DallinLowEngineering/QC_CNC_Machine/QC CNC V2, BOM (No links; SW Gen.).xlsx

ITEM NO. | PART NUMBER | QTY.
1 | 400mm (T-Slot, 2040) | 2
2 | 400mm (T-Slot, 2020) | 3
3 | B18.6.7M - M4 x 0.7 x 16 Type I Cross Recessed PHMS --16N | 12
4 | T-Nut, m4 | 39
5 | B18.2.4.1M - Hex nut, Style 1, M4 x 0.7 --D-N | 15
6 | Reverse Adapter, Pillow Block, M4 to M4 | 3
7 | Pillow Block, 8mm clearance, Fasteners M4 | 3
8 | Lead Screw Coupler, 5-8mm | 3
9 | 300mm (Lead Screw, T8) | 3
10 | 3D Printed, Motor Bracket, RH, Nema 17 | 3
11 | Stepper Motor, Nema 17 | 3
12 | B18.6.7M - M3 x 0.5 x 5 Type I Cross Recessed PHMS --5N | 12
13 | B18.6.7M - M4 x 0.7 x 8 Type I Cross Recessed PHMS --8N | 16
14 | Corner Bracket, 2020, 6mm holes | 6
15 | T-Slot, 2020 | 1
16 | Mounting Plate, Electronics | 1
17 | B18.6.7M - M4 x 0.7 x 13 Type I Cross Recessed PHMS --13N | 9
18 | B18.22M - Plain washer, 4 mm, regular | 18
19 | Board, Ramps 1.4 | 1
20 | DIN Rail (8961K150) | 2
21 | 3D Printed, DIN Mounts, Arduino Mega | 2
22 | Board, Arduino Mega | 1
23 | B18.6.7M - M3 x 0.5 x 13 Type I Cross Recessed PHMS --13N | 4
24 | B18.2.4.1M - Hex nut, Style 1, M3 x 0.5 --D-N | 20
25 | 12V Power Supply | 1
26 | 3D Printed, Wheel Carriage, Front, 2020, V2 | 2
27 | Wheel, Preloaded, 5mm bore | 9
28 | T8 (Lead Screw Nut) | 3
29 | 3D Printed, Wheel Carriage, Rear, 2020, Y, V2 | 2
30 | Spacer, M4, 10mm | 18
31 | m4x50mm, PHIL, Pan Head | 9
32 | B18.21.2M-Internal Tooth Lock Washers_AM4 | 9
33 | B18.6.7M - M3 x 0.5 x 16 Type I Cross Recessed PHMS --16N | 16
34 | 3D Printed, Wheel Carriage, Front, 2020, Reflected, V2 | 1
35 | 3D Printed, Wheel Carriage, Rear, 2020, V2 | 1
36 | Laser Diode | 1
37 | ToF laser Board | 1
38 | 3D Printed, Laser Bracket, Actual | 1
39 | 3D Printed, Bracket, End Stop | 2
40 | Board, End Stop | 2
41 | B18.6.7M - M3 x 0.5 x 8 Type I Cross Recessed PHMS --8NPCS | 4
42 | B18.6.7M - M4 x 0.7 x 8 Type I Cross Recessed PHMS --8NPCS | 4
43 | B18.6.7M - M4 x 0.7 x 10 Type I Cross Recessed PHMS --10NPCS | 4
