DallinLowEngineering/QC_CNC_Machine/RH, Y-Carriage, V2.SLDASM

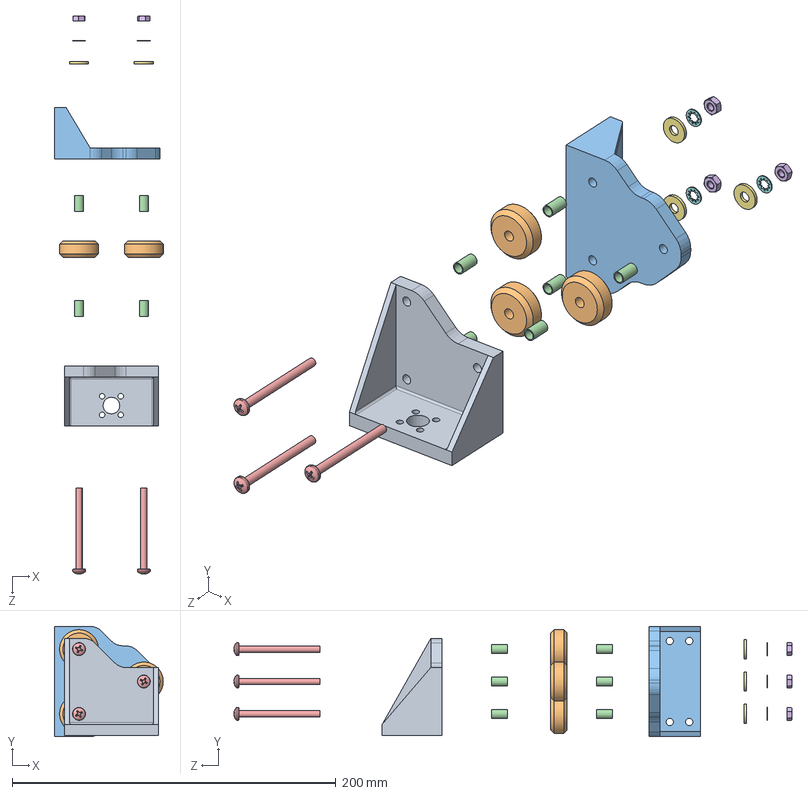
[picture p1: CAD file, 2021-05-12]
RH, Y-Carriage, V2.SLDASM
67.0 x 68.0 x 344.5 mm
3D Printed, Wheel Carriage, Front, 2020, Reflected, V2
Wheel, Preloaded, 5mm bore x 3
3D Printed, Wheel Carriage, Rear, 2020, Y, V2
Spacer, M4, 10mm x 6
m4x50mm, PHIL, Pan Head x 3
hex nut style 1_am x 3
flat washer regular_am x 3
internal tooth lock washer_am x 3
