DallinLowEngineering/QC_CNC_Machine/LH, Y-Carriage, V2.SLDASM

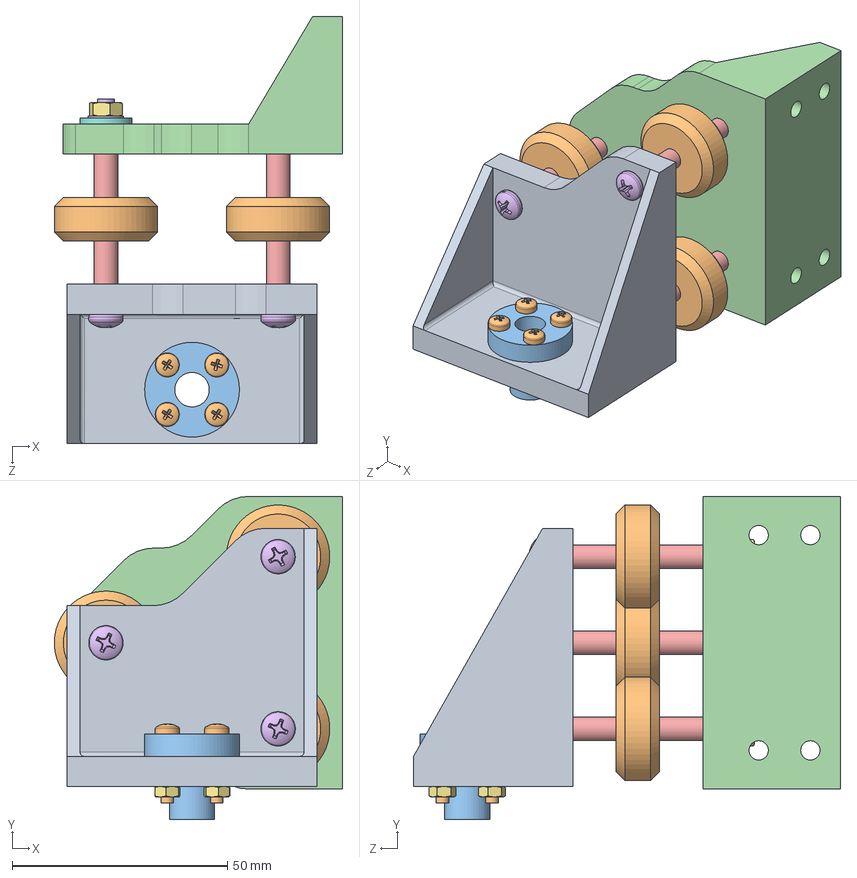
[picture p2: CAD file, 2021-05-12]
LH, Y-Carriage, V2.SLDASM
67.0 x 75.1 x 99.2 mm
3D Printed, Wheel Carriage, Front, 2020, V2
Wheel, Preloaded, 5mm bore x 3
Lead Screw Nut, M8 (Standin; 2391N110)
3D Printed, Wheel Carriage, Rear, 2020, Y, V2
Spacer, M4, 10mm x 6
m4x50mm, PHIL, Pan Head x 3
hex nut style 1_am x 7
flat washer regular_am x 3
internal tooth lock washer_am x 3
pan cross head_am x 4
