DallinLowEngineering/QC_CNC_Machine/X-Carriage, QC Range Finder.SLDASM

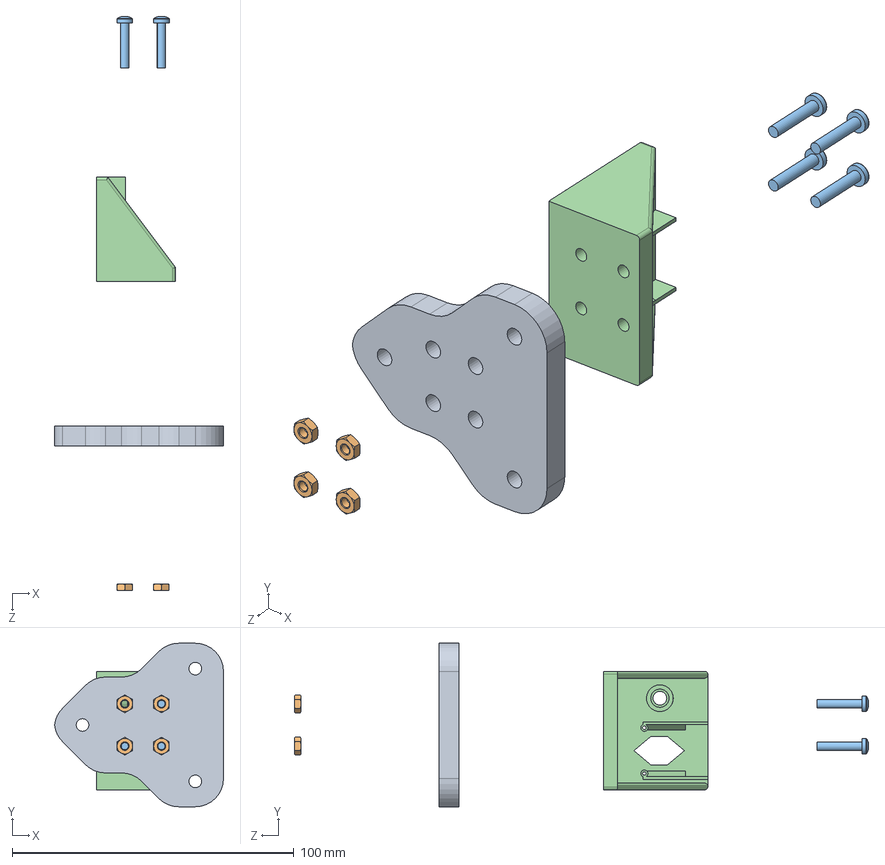
[picture p3: CAD file, 2021-05-12]
X-Carriage, QC Range Finder.SLDASM
59.9 x 58.0 x 203.7 mm
3D Printed, Wheel Carriage, Rear, 2020, V2
hex nut style 1_am x 4
pan cross head_am x 4
3D Printed, Laser Bracket, Actual
