DallinLowEngineering/QC_CNC_Machine/3D Printed, Bracket, End Stop.STEP

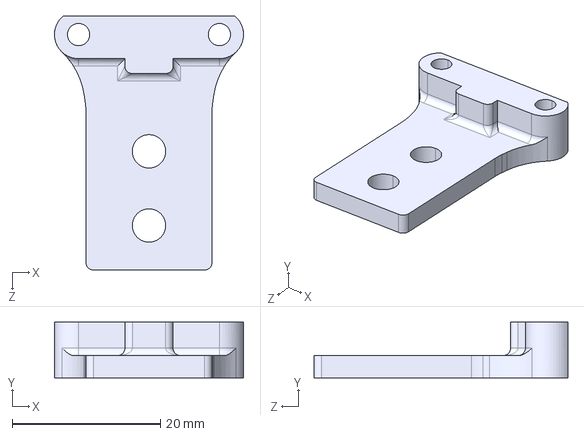
[picture p4: CAD file, 2021-05-12]
3D Printed, Bracket, End Stop.STEP
25.5 x 7.50 x 34.3 mm
