DallinLowEngineering/QC_CNC_Machine/3D Printed, Wheel Carriage, Front, 2020, V2.STEP

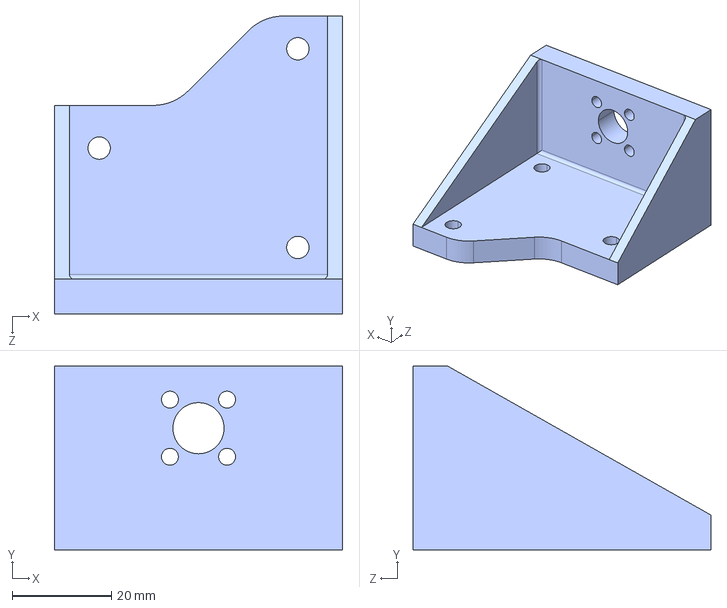
[picture p5: CAD file, 2021-05-12]
3D Printed, Wheel Carriage, Front, 2020, V2.STEP
58.0 x 37.0 x 60.0 mm
