DallinLowEngineering/QC_CNC_Machine/T-Nut, m4.SLDPRT

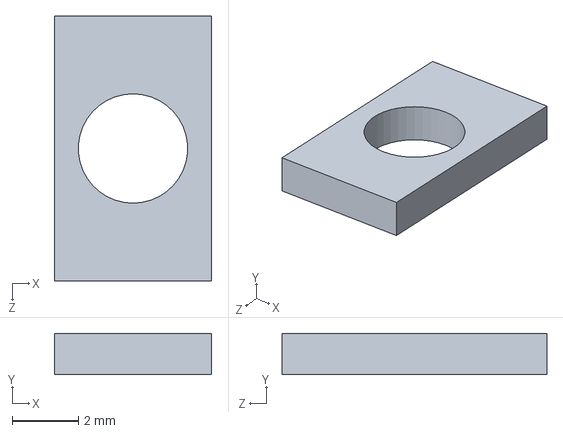
[picture p6: CAD file, 2021-05-12]
T-Nut, m4.SLDPRT
4.75 x 1.25 x 8.00 mm
