DallinLowEngineering/QC_CNC_Machine/Spacer, M4, 10mm.SLDPRT

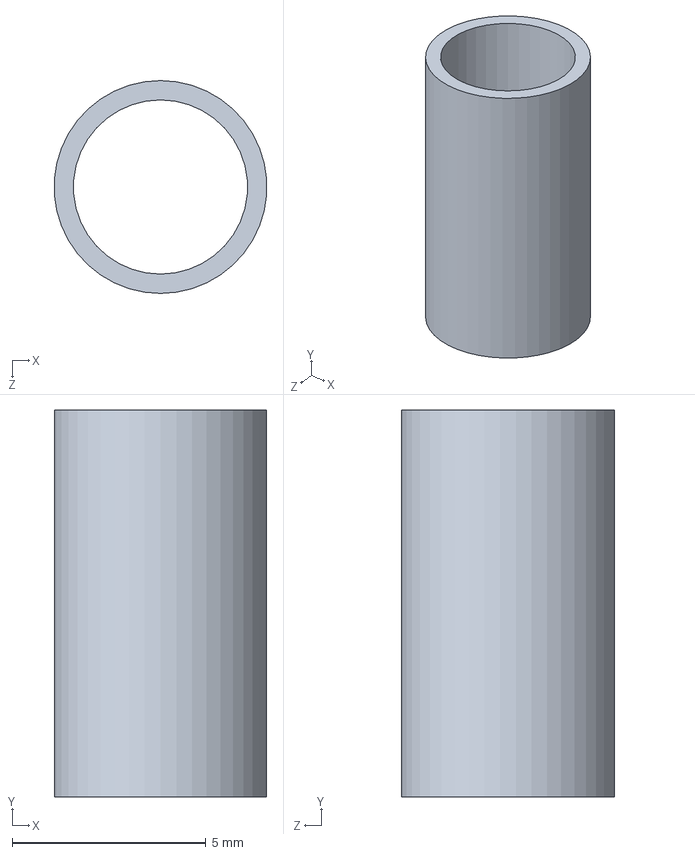
[picture p7: CAD file, 2021-05-12]
Spacer, M4, 10mm.SLDPRT
5.48 x 10.0 x 5.50 mm
