DallinLowEngineering/QC_CNC_Machine/DIN Rail (8961K150).SLDPRT

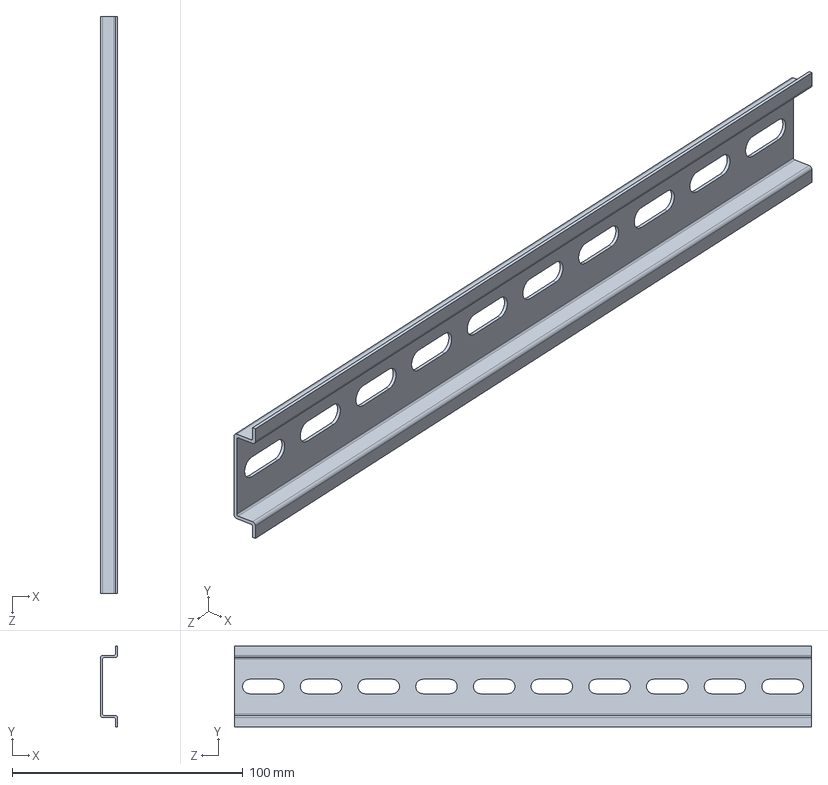
[picture p8: CAD file, 2021-05-12]
DIN Rail (8961K150).SLDPRT
7.50 x 35.0 x 250.0 mm
