DallinLowEngineering/QC_CNC_Machine/T-Slot, 2040.SLDPRT

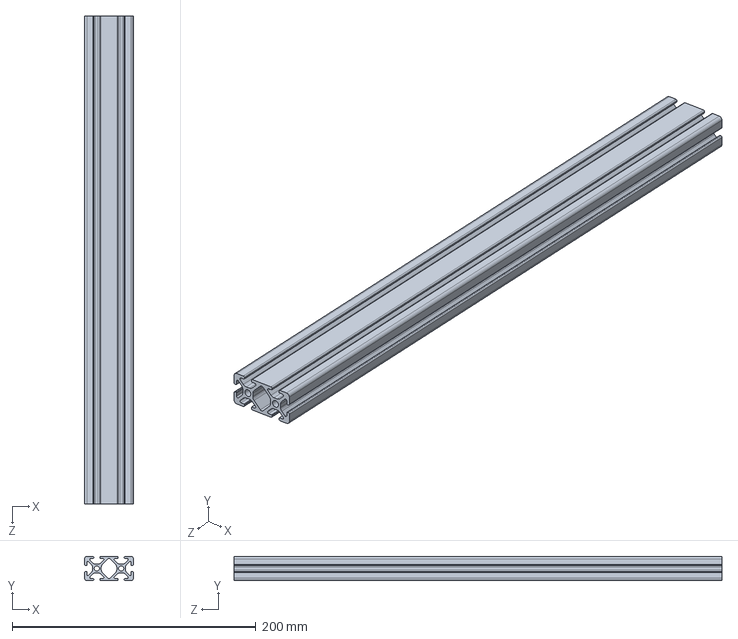
[picture p9: CAD file, 2021-05-12]
T-Slot, 2040.SLDPRT
40.0 x 20.0 x 400.0 mm
