DallinLowEngineering/QC_CNC_Machine/12V Power Supply.SLDPRT

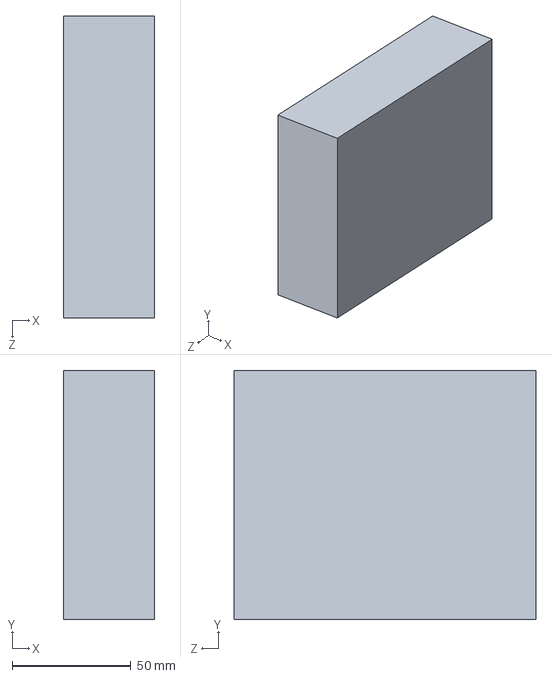
[picture p10: CAD file, 2021-05-12]
12V Power Supply.SLDPRT
38.1 x 104.8 x 127.0 mm
