DallinLowEngineering/QC_CNC_Machine/3D Printed, Motor Bracket, RH, Nema 17.STEP

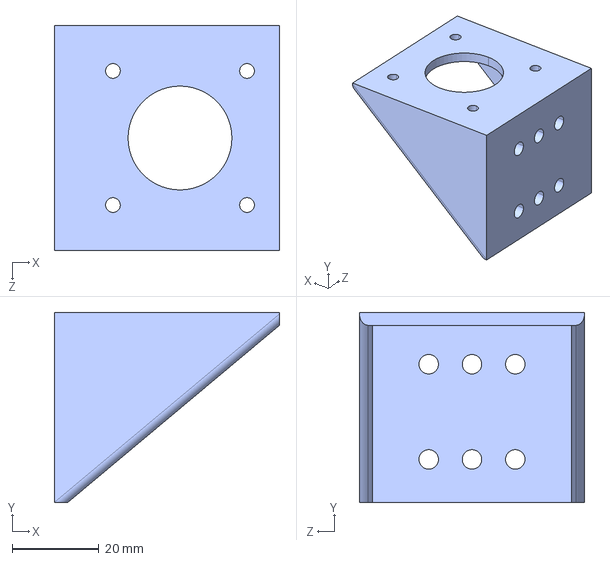
[picture p11: CAD file, 2021-05-12]
3D Printed, Motor Bracket, RH, Nema 17.STEP
52.0 x 44.0 x 52.0 mm
