DallinLowEngineering/QC_CNC_Machine/Pillow Block, 8mm clearance, Fasteners M4.SLDPRT

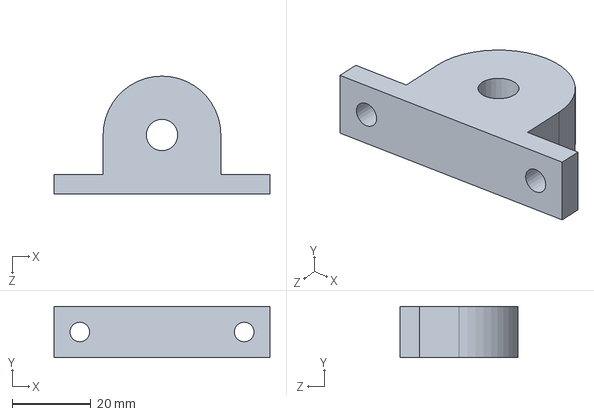
[picture p12: CAD file, 2021-05-12]
Pillow Block, 8mm clearance, Fasteners M4.SLDPRT
55.0 x 13.0 x 30.0 mm
