DallinLowEngineering/QC_CNC_Machine/ToF laser Board.SLDPRT

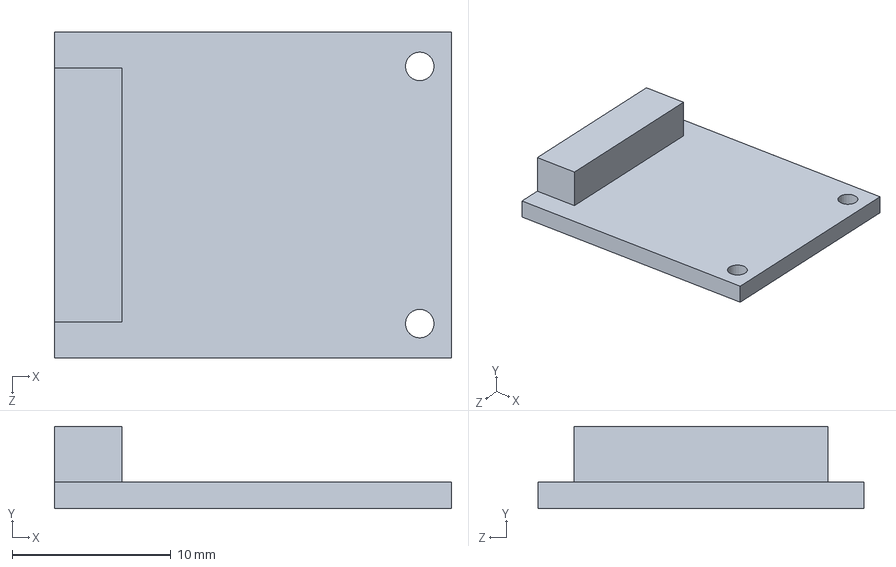
[picture p13: CAD file, 2021-05-12]
ToF laser Board.SLDPRT
25.0 x 5.17 x 20.5 mm
