DallinLowEngineering/QC_CNC_Machine/Board, End Stop.SLDPRT

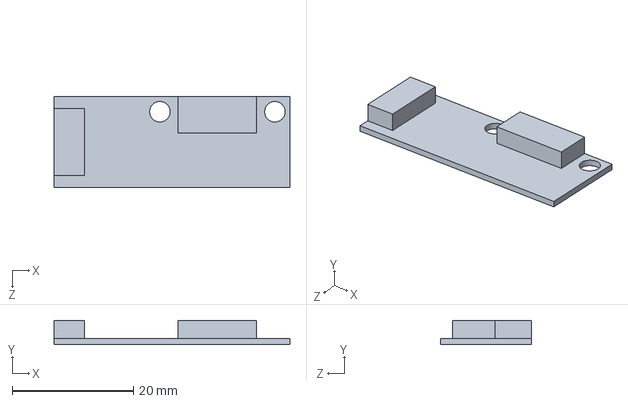
[picture p14: CAD file, 2021-05-12]
Board, End Stop.SLDPRT
39.0 x 4.00 x 15.0 mm
