DallinLowEngineering/QC_CNC_Machine/Board, Arduino Mega.SLDPRT

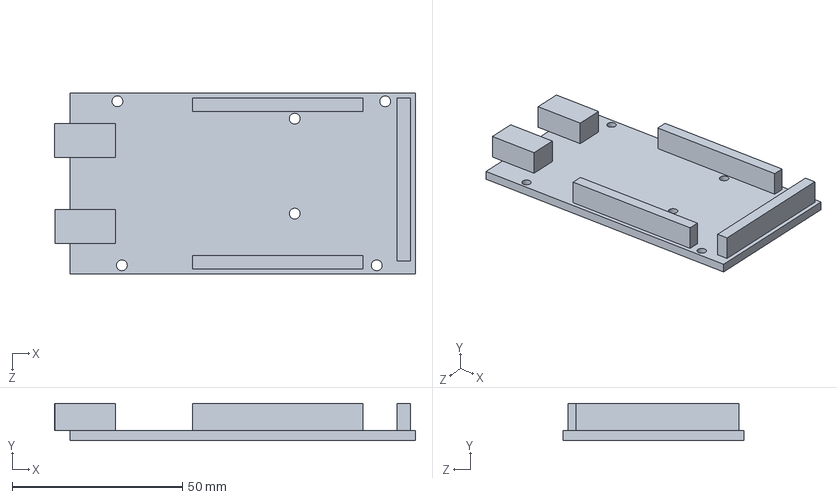
[picture p15: CAD file, 2021-05-12]
Board, Arduino Mega.SLDPRT
106.1 x 11.0 x 53.3 mm
