DallinLowEngineering/QC_CNC_Machine/Mounting Plate, Electronics.SLDPRT

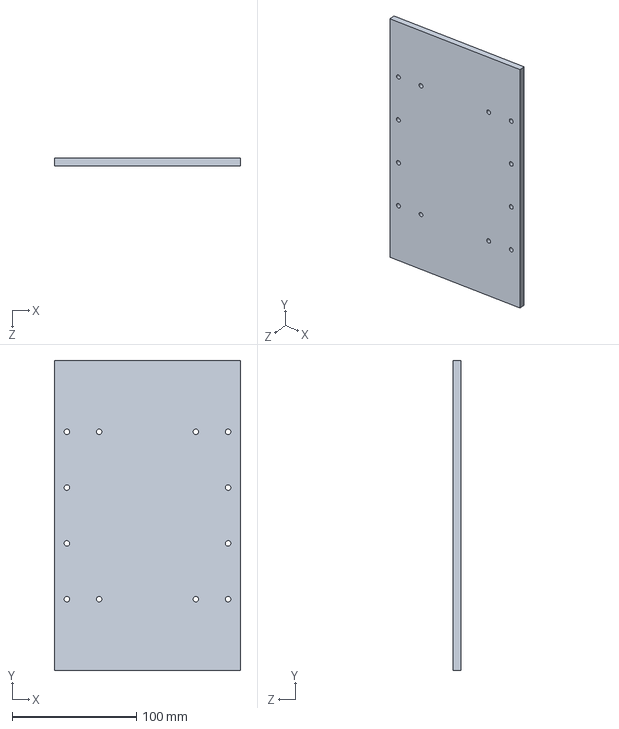
[picture p16: CAD file, 2021-05-12]
Mounting Plate, Electronics.SLDPRT
150.0 x 250.0 x 6.35 mm
