DallinLowEngineering/QC_CNC_Machine/3D Printed, Wheel Carriage, Rear, 2020, V2.STEP

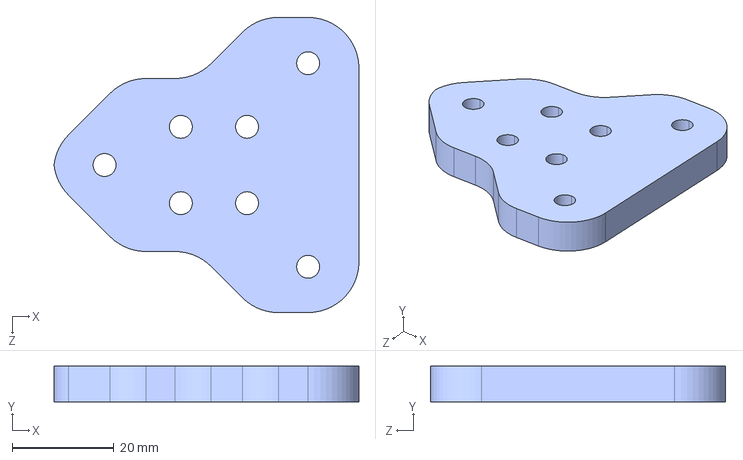
[picture p17: CAD file, 2021-05-12]
3D Printed, Wheel Carriage, Rear, 2020, V2.STEP
59.9 x 7.00 x 58.0 mm
