DallinLowEngineering/QC_CNC_Machine/Laser Diode.SLDPRT

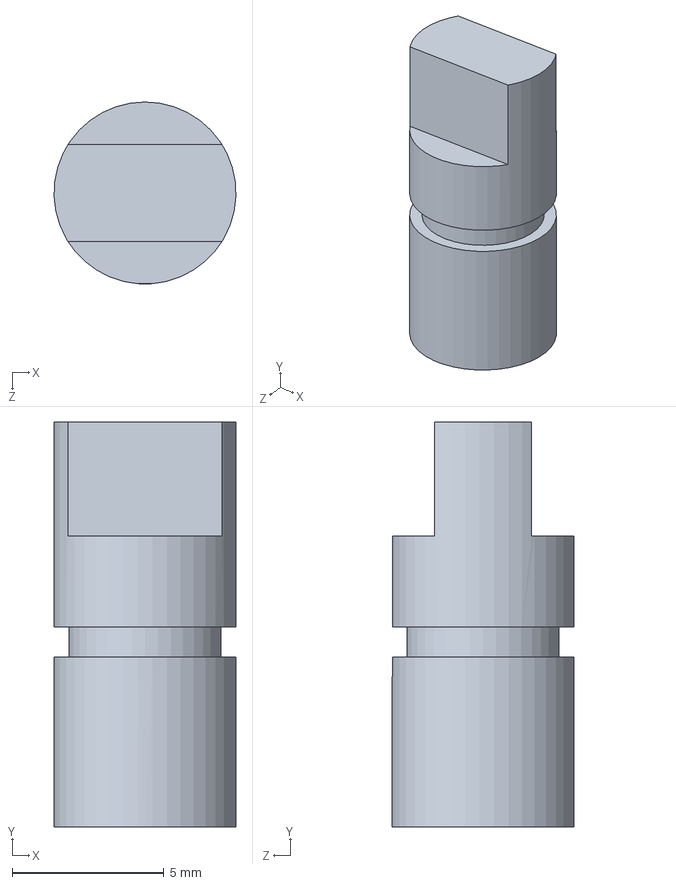
[picture p18: CAD file, 2021-05-12]
Laser Diode.SLDPRT
6.00 x 13.3 x 6.00 mm
