DallinLowEngineering/QC_CNC_Machine/3D Printed, Laser Bracket, Actual.STEP

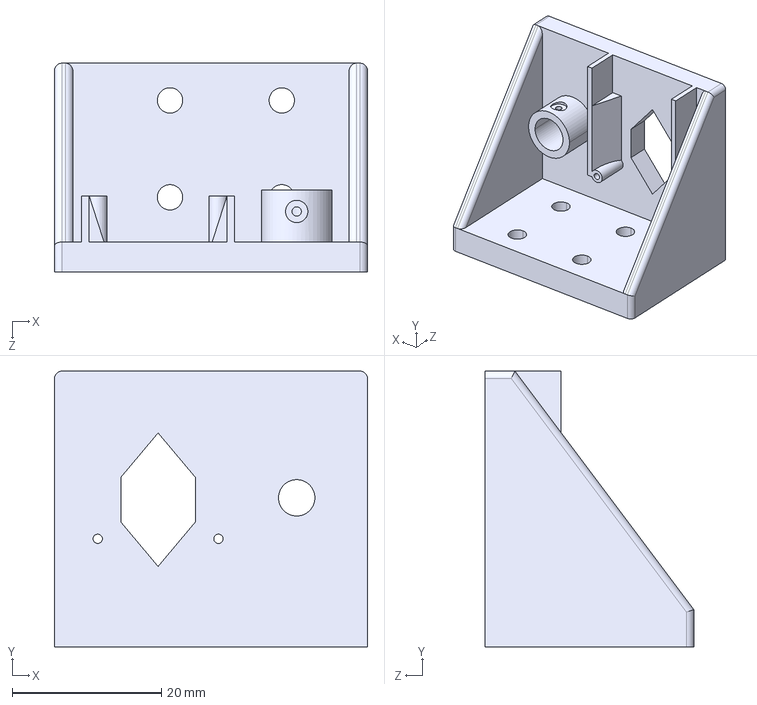
[picture p19: CAD file, 2021-05-12]
3D Printed, Laser Bracket, Actual.STEP
42.0 x 37.0 x 28.0 mm
