DallinLowEngineering/QC_CNC_Machine/Board, Ramps 1.4.SLDPRT

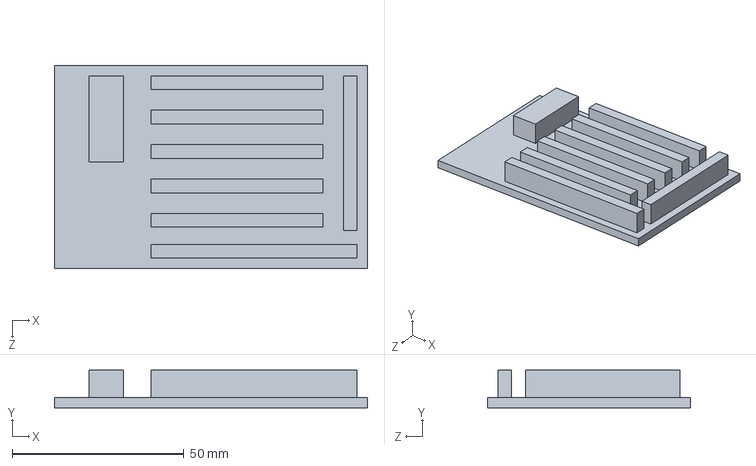
[picture p20: CAD file, 2021-05-12]
Board, Ramps 1.4.SLDPRT
91.0 x 11.0 x 59.0 mm
