DallinLowEngineering/QC_CNC_Machine/Reverse Adapter, Pillow Block, M4 to M4.STEP

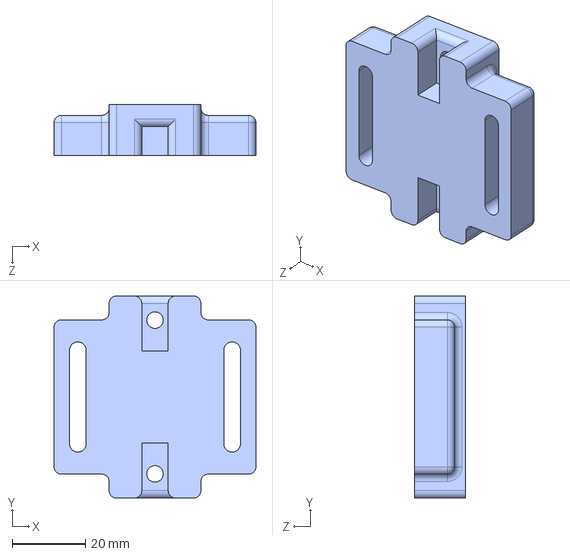
[picture p21: CAD file, 2021-05-12]
Reverse Adapter, Pillow Block, M4 to M4.STEP
55.0 x 55.0 x 14.0 mm
