DallinLowEngineering/QC_CNC_Machine/Corner Bracket, 2020, 6mm holes.SLDPRT

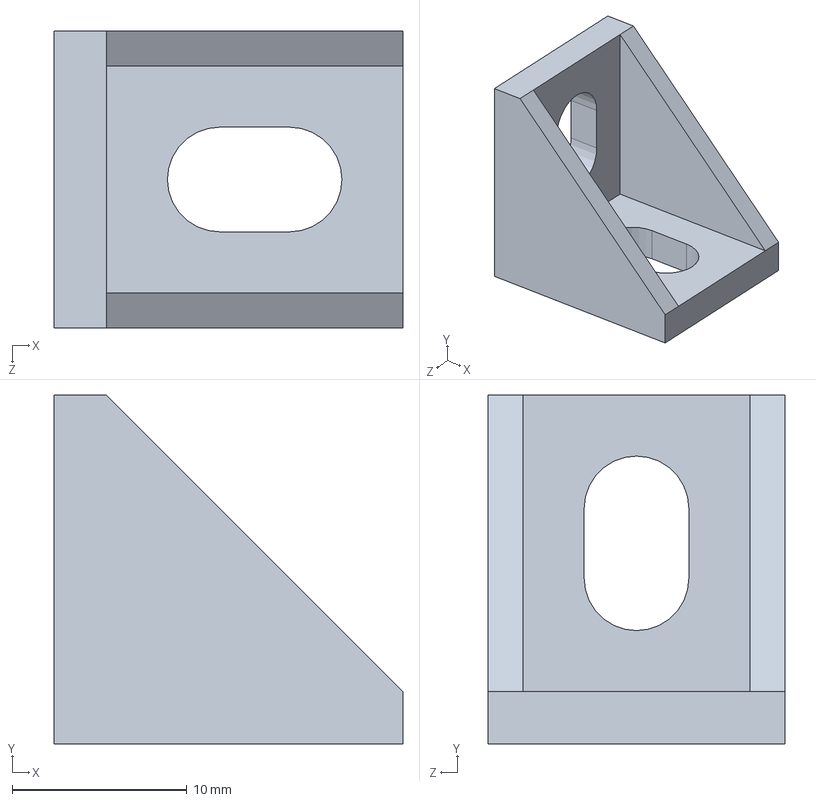
[picture p22: CAD file, 2021-05-12]
Corner Bracket, 2020, 6mm holes.SLDPRT
20.0 x 20.0 x 17.0 mm
