DallinLowEngineering/QC_CNC_Machine/3D Printed, Wheel Carriage, Rear, 2020, Y, V2.STEP

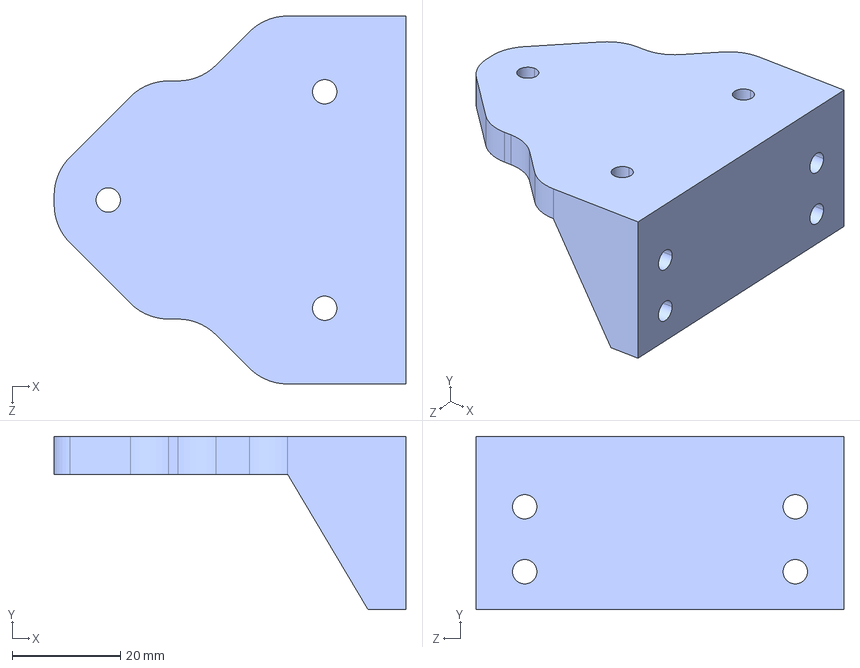
[picture p23: CAD file, 2021-05-12]
3D Printed, Wheel Carriage, Rear, 2020, Y, V2.STEP
65.0 x 32.0 x 68.0 mm
