DallinLowEngineering/QC_CNC_Machine/Wheel, Preloaded, 5mm bore.SLDPRT

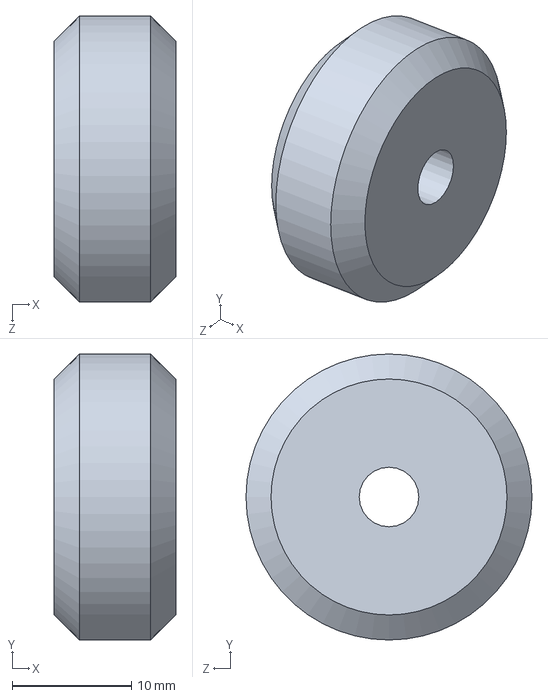
[picture p24: CAD file, 2021-05-12]
Wheel, Preloaded, 5mm bore.SLDPRT
10.2 x 24.0 x 24.0 mm
