DallinLowEngineering/QC_CNC_Machine/Stepper Motor, Nema 17 (6627T660).SLDPRT

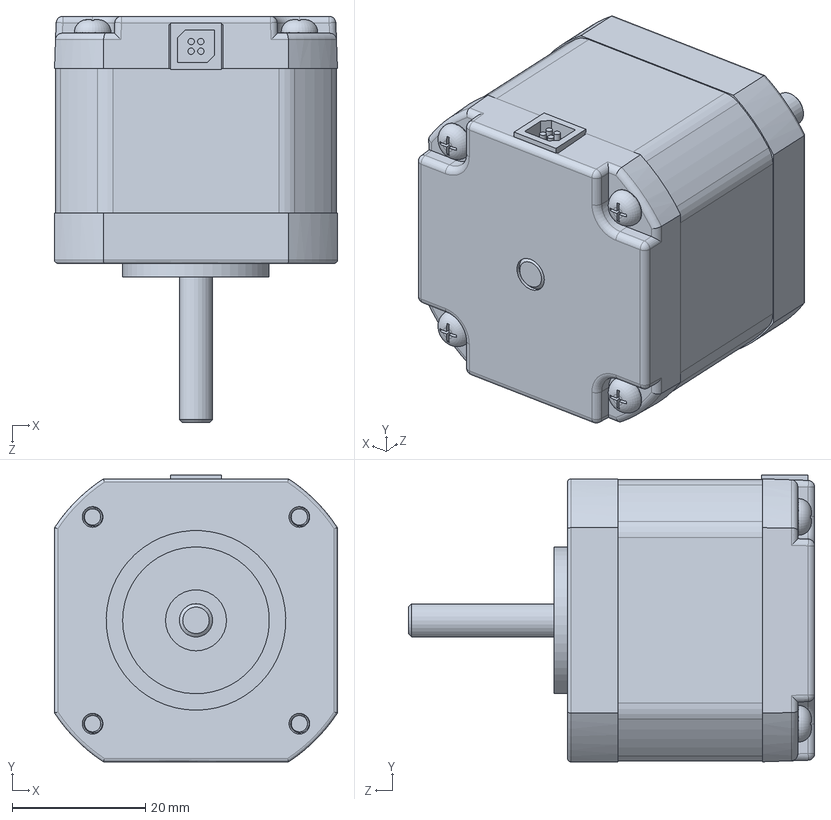
[picture p25: CAD file, 2021-05-12]
Stepper Motor, Nema 17 (6627T660).SLDPRT
42.4 x 43.0 x 60.9 mm
