DallinLowEngineering/QC_CNC_Machine/3D Printed, DIN Mounts, Arduino Mega.STEP

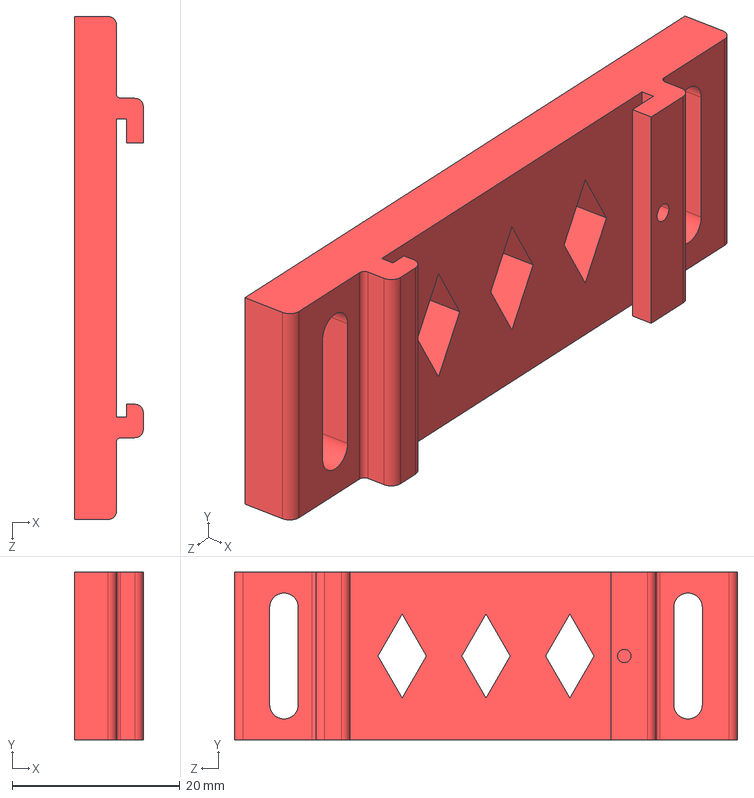
[picture p26: CAD file, 2021-05-12]
3D Printed, DIN Mounts, Arduino Mega.STEP
8.20 x 20.0 x 60.0 mm
