DallinLowEngineering/QC_CNC_Machine/T-Slot, 2020.SLDPRT

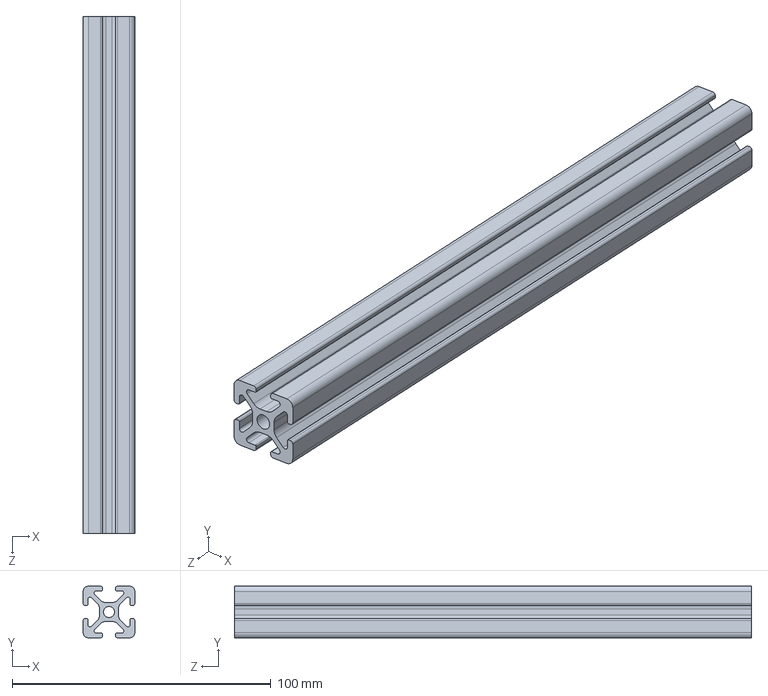
[picture p27: CAD file, 2021-05-12]
T-Slot, 2020.SLDPRT
20.0 x 20.0 x 200.0 mm
