DallinLowEngineering/QC_CNC_Machine/(list of files, cad)

Other CAD files:
3D Printed, Wheel Carriage, Front, 2020, Reflected, V2.STEP
3D Printed, Bracket, End Stop.SLDPRT
3D Printed, Bracket, End Stop.STL
3D Printed, DIN Mounts, Arduino Mega.SLDPRT
3D Printed, DIN Mounts, Arduino Mega.STL
3D Printed, Laser Bracket, Actual.SLDPRT
3D Printed, Laser Bracket, Actual.STL
3D Printed, Motor Bracket, RH, Nema 17.SLDPRT
3D Printed, Motor Bracket, RH, Nema 17.STL
3D Printed, Wheel Carriage, Front, 2020, Reflected, V2.SLDPRT
3D Printed, Wheel Carriage, Front, 2020, Reflected, V2.STL
3D Printed, Wheel Carriage, Front, 2020, V2.SLDPRT
3D Printed, Wheel Carriage, Front, 2020, V2.STL
3D Printed, Wheel Carriage, Rear, 2020, V2.SLDPRT
3D Printed, Wheel Carriage, Rear, 2020, V2.STL
3D Printed, Wheel Carriage, Rear, 2020, Y, V2.SLDPRT
3D Printed, Wheel Carriage, Rear, 2020, Y, V2.STL
Lead Screw Coupler, 5-8mm.SLDPRT
Lead Screw Nut, M8 (Standin; 2391N110).SLDPRT
Lead Screw, M8 (T8 Stand-in), 300mm (7549K570).SLDPRT
Mounting Plate, Electronics.SLDDRW
QC CNC Machine V2, Assembly (PRJ3).SLDDRW
Reverse Adapter, Pillow Block, M4 to M4.SLDPRT
Reverse Adapter, Pillow Block, M4 to M4.STL
m4x50mm, PHIL, Pan Head.SLDPRT
