DallinLowEngineering/QC_CNC_Machine/QC CNC Machine V2, Assembly Drawing (PRJ3).PDF

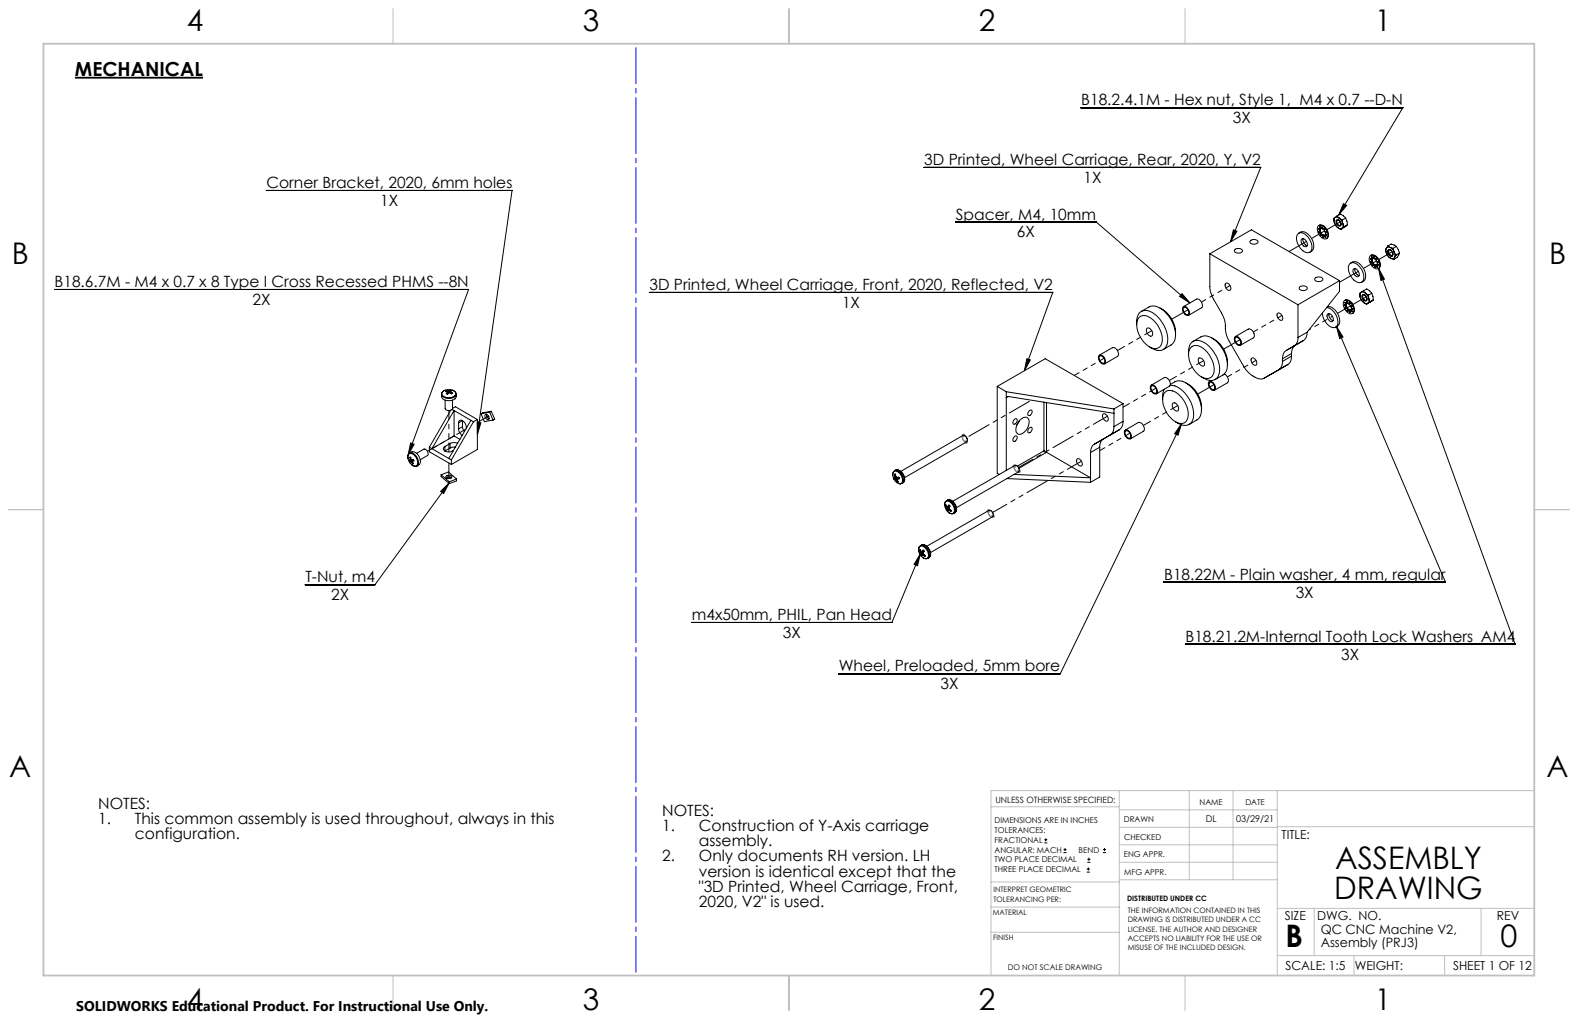
[picture p28: page 1]
T-Nut, m4; Spacer, M4, 10mm; SHEET 1 OF 12; SCALE: 1:5; WEIGHT:

B18.2.4.1M - Hex nut, Style 1, M4 x 0.7 --D-N

3D Printed, Wheel Carriage, Rear, 2020, Y, V2

Corner Bracket, 2020, 6mm holes

B18.6.7M - M4 x 0.7 x 8 Type I Cross Recessed PHMS --8N

3D Printed, Wheel Carriage, Front, 2020, Reflected, V2

B18.22M - Plain washer, 4 mm, regular

m4x50mm, PHIL, Pan Head

Wheel, Preloaded, 5mm bore

B18.21.2M-Internal Tooth Lock Washers_AM4

NOTES:
1. This common assembly is used throughout, always in this
configuration.

1. Construction of Y-Axis carriage
assembly.
2. Only documents RH version. LH
version is identical except that the
"3D Printed, Wheel Carriage, Front,
2020, V2" is used.

UNLESS OTHERWISE SPECIFIED: | | NAME | DATE
DIMENSIONS ARE IN INCHES TOLERANCES: FRACTIONAL ANGULAR: MACH BEND TWO PLACE DECIMAL THREE PLACE DECIMAL | DRAWN | DL | 03/29/21

CHECKED | | | TITLE: ASSEMBLY DRAWING

ENG APPR.
MFG APPR.

INTERPRET GEOMETRIC TOLERANCING PER: | DISTRIBUTED UNDER CC THE INFORMATION CONTAINED IN THIS DRAWING IS DISTRIBUTED UNDER A CC LICENSE. THE AUTHOR AND DESIGNER ACCEPTS NO LIABILITY FOR THE USE OR MISUSE OF THE INCLUDED DESIGN.
MATERIAL | | SIZE B | DWG. NO. QC CNC Machine V2, Assembly (PRJ3) | REV 0

DO NOT SCALE DRAWING

SOLIDWORKS Educational Product. For Instructional Use Only.

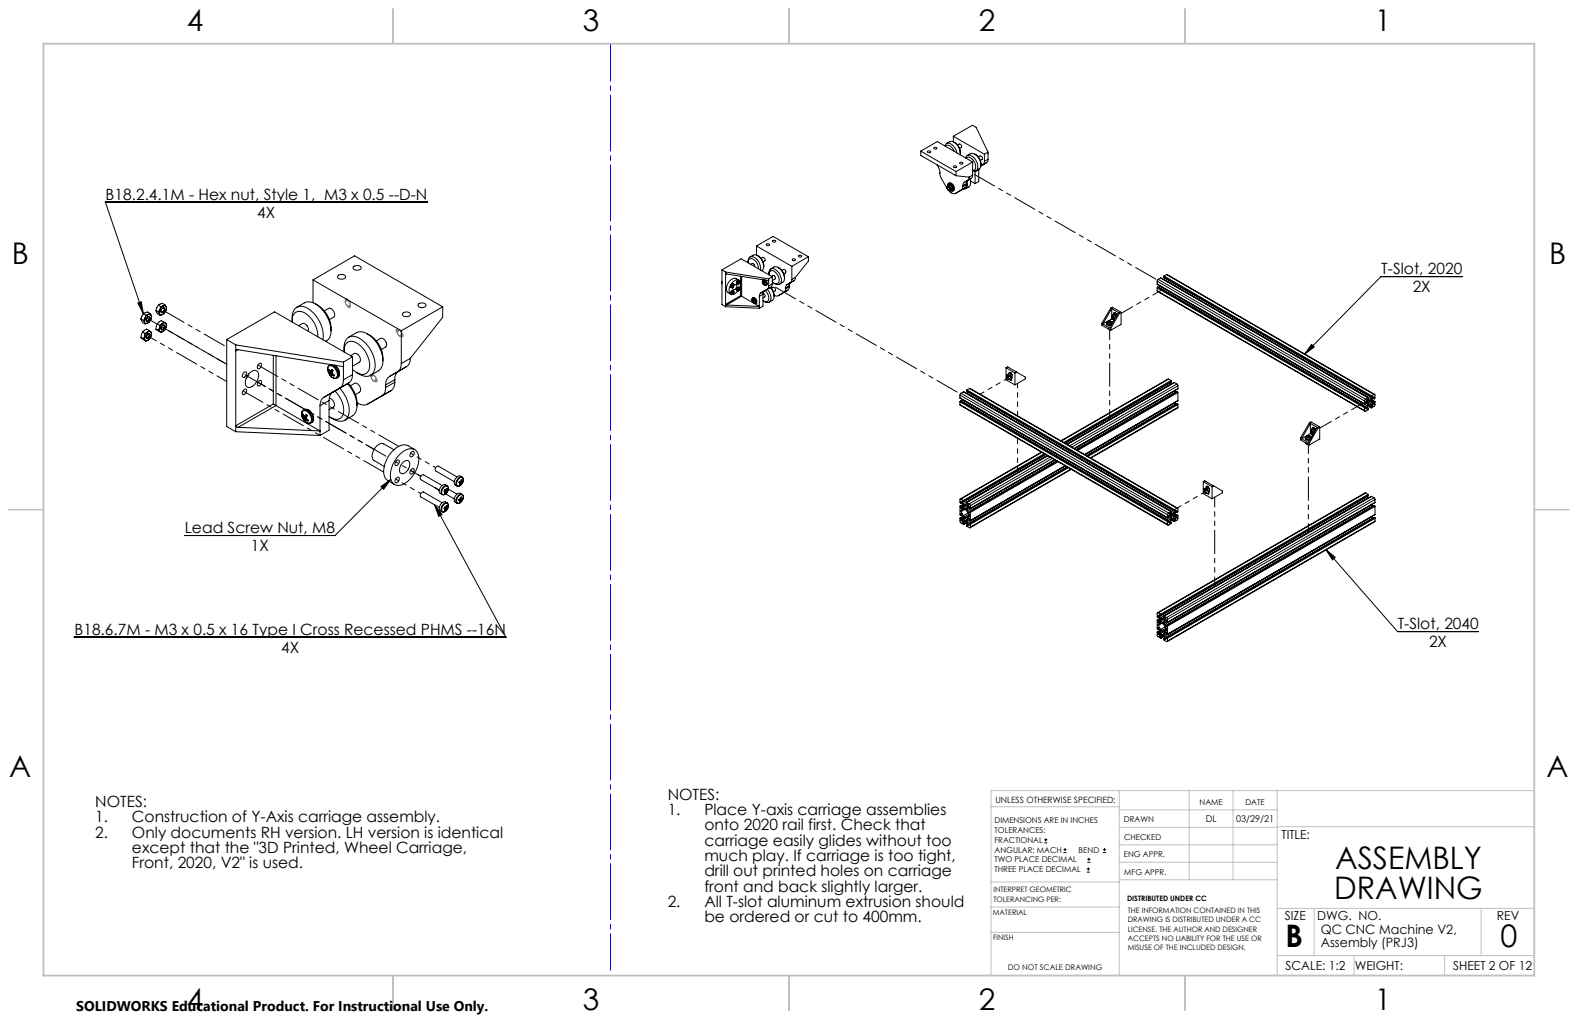
[picture p29: page 2]
T-Slot, 2020; T-Slot, 2040; SCALE: 1:2; WEIGHT:

B18.2.4.1M - Hex nut, Style 1, M3 x 0.5 --D-N

Lead Screw Nut, M8

B18.6.7M - M3 x 0.5 x 16 Type I Cross Recessed PHMS --16N

NOTES:
1. Place Y-axis carriage assemblies
onto 2020 rail first. Check that
carriage easily glides without too
much play. If carriage is too tight,
drill out printed holes on carriage
front and back slightly larger.
2. All T-slot aluminum extrusion should
be ordered or cut to 400mm.

1. Construction of Y-Axis carriage assembly.
2. Only documents RH version. LH version is identical
except that the "3D Printed, Wheel Carriage,
Front, 2020, V2" is used.

UNLESS OTHERWISE SPECIFIED: | | NAME | DATE
DIMENSIONS ARE IN INCHES TOLERANCES: FRACTIONAL ANGULAR: MACH BEND TWO PLACE DECIMAL THREE PLACE DECIMAL | DRAWN | DL | 03/29/21

CHECKED | | | TITLE: ASSEMBLY DRAWING

ENG APPR.
MFG APPR.

INTERPRET GEOMETRIC TOLERANCING PER: | DISTRIBUTED UNDER CC THE INFORMATION CONTAINED IN THIS DRAWING IS DISTRIBUTED UNDER A CC LICENSE. THE AUTHOR AND DESIGNER
MATERIAL | | SIZE B | DWG. NO. QC CNC Machine V2, | REV 0

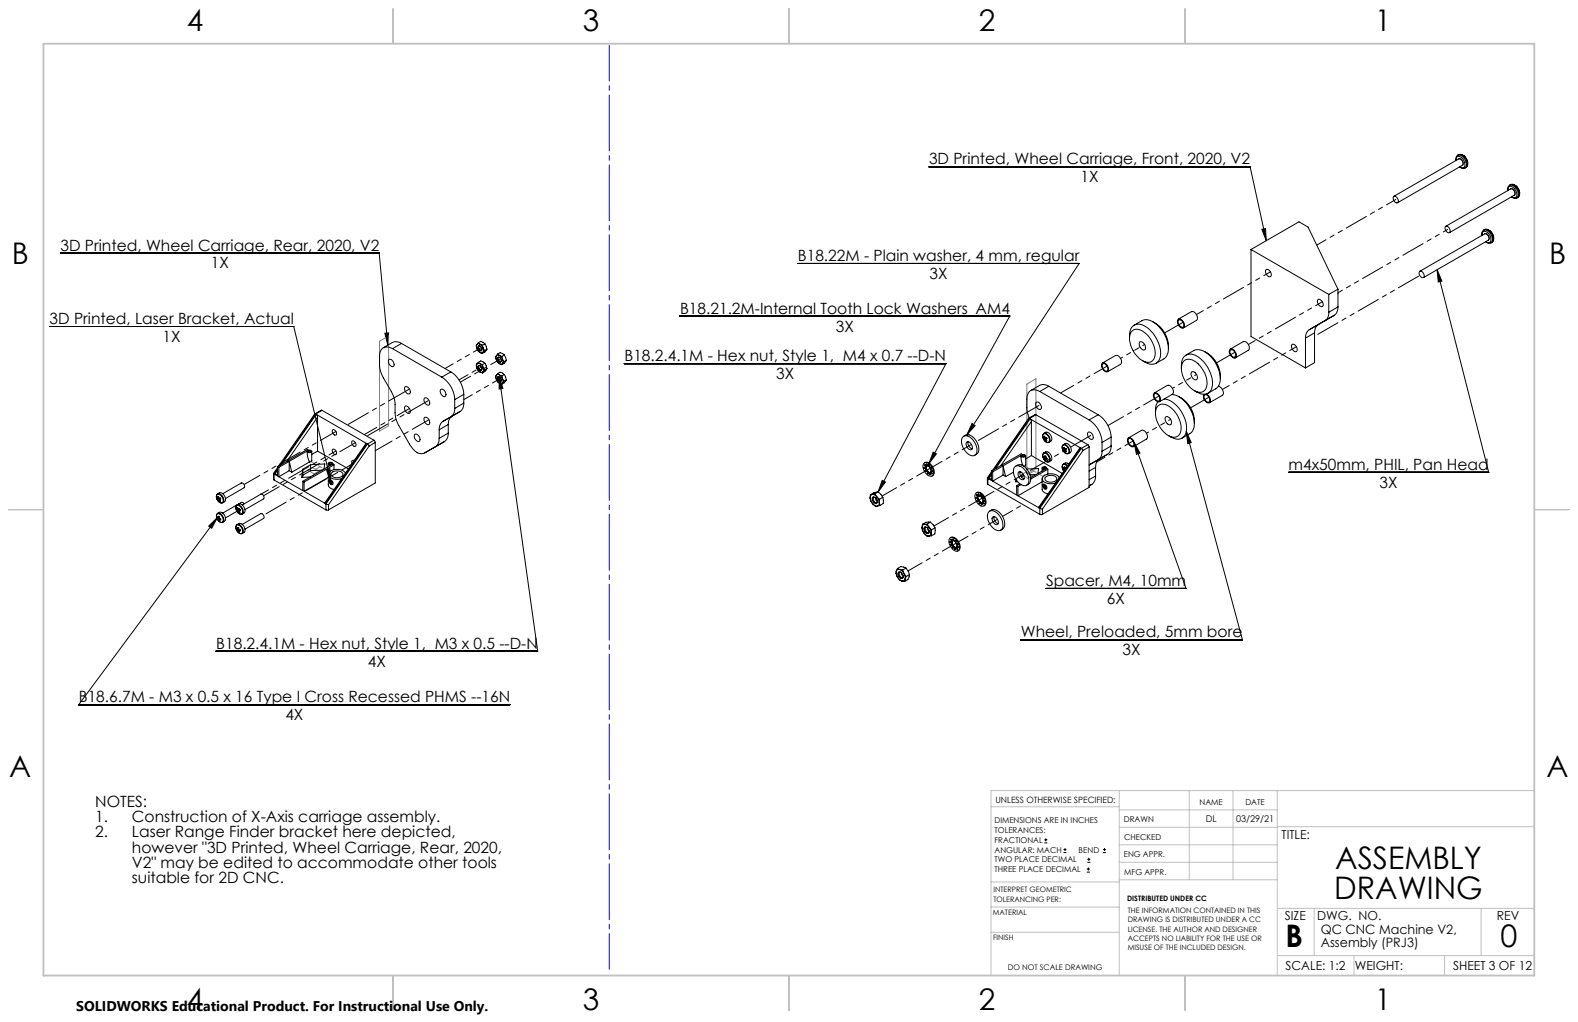
[picture p30: page 3]
Spacer, M4, 10mm

3D Printed, Wheel Carriage, Front, 2020, V2

3D Printed, Wheel Carriage, Rear, 2020, V2

B18.22M - Plain washer, 4 mm, regular

B18.21.2M-Internal Tooth Lock Washers_AM4

3D Printed, Laser Bracket, Actual

B18.2.4.1M - Hex nut, Style 1, M4 x 0.7 --D-N

m4x50mm, PHIL, Pan Head

Wheel, Preloaded, 5mm bore

B18.2.4.1M - Hex nut, Style 1, M3 x 0.5 --D-N

B18.6.7M - M3 x 0.5 x 16 Type I Cross Recessed PHMS --16N

NOTES:
1. Construction of X-Axis carriage assembly.
2. Laser Range Finder bracket here depicted,
however "3D Printed, Wheel Carriage, Rear, 2020,
V2" may be edited to accommodate other tools
suitable for 2D CNC.

UNLESS OTHERWISE SPECIFIED: | | NAME | DATE
DIMENSIONS ARE IN INCHES TOLERANCES: FRACTIONAL ANGULAR: MACH BEND TWO PLACE DECIMAL THREE PLACE DECIMAL | DRAWN | DL | 03/29/21

CHECKED | | | TITLE: ASSEMBLY DRAWING

ENG APPR.
MFG APPR.

INTERPRET GEOMETRIC TOLERANCING PER: | DISTRIBUTED UNDER CC THE INFORMATION CONTAINED IN THIS DRAWING IS DISTRIBUTED UNDER A CC LICENSE. THE AUTHOR AND DESIGNER
MATERIAL | | SIZE B | DWG. NO. QC CNC Machine V2, | REV 0

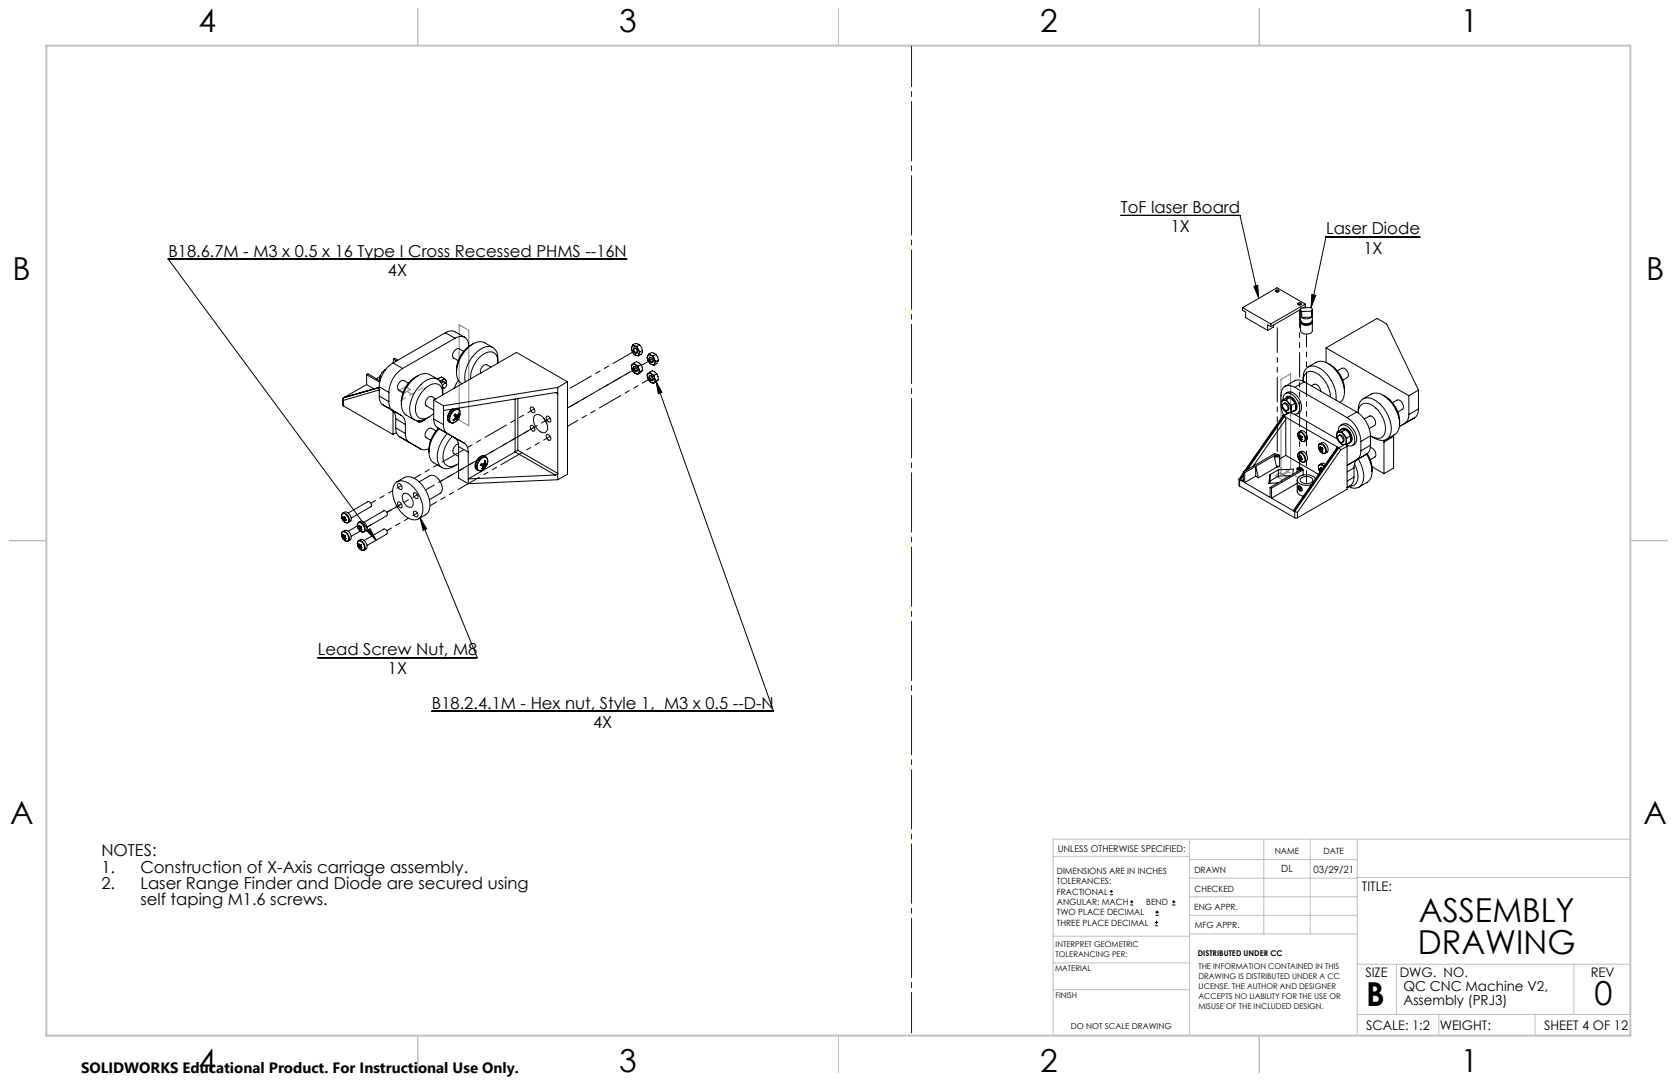
[picture p31: page 4]
Laser Diode; B18.6.7M - M3 x 0.5 x 16 Type I Cross Recessed PHMS --16N; self taping M1.6 screws.; ASSEMBLY

ToF laser Board

Lead Screw Nut, M8

B18.2.4.1M - Hex nut, Style 1, M3 x 0.5 --D-N

NOTES:
1. Construction of X-Axis carriage assembly.
2. Laser Range Finder and Diode are secured using

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

CHECKED | | | TITLE: DRAWING

ENG APPR.
MFG APPR.

INTERPRET GEOMETRIC TOLERANCING PER: | DISTRIBUTED UNDER CC THE INFORMATION CONTAINED IN THIS DRAWING IS DISTRIBUTED UNDER A CC LICENSE. THE AUTHOR AND DESIGNER
MATERIAL | | SIZE B | DWG. NO. QC CNC Machine V2, | REV 0

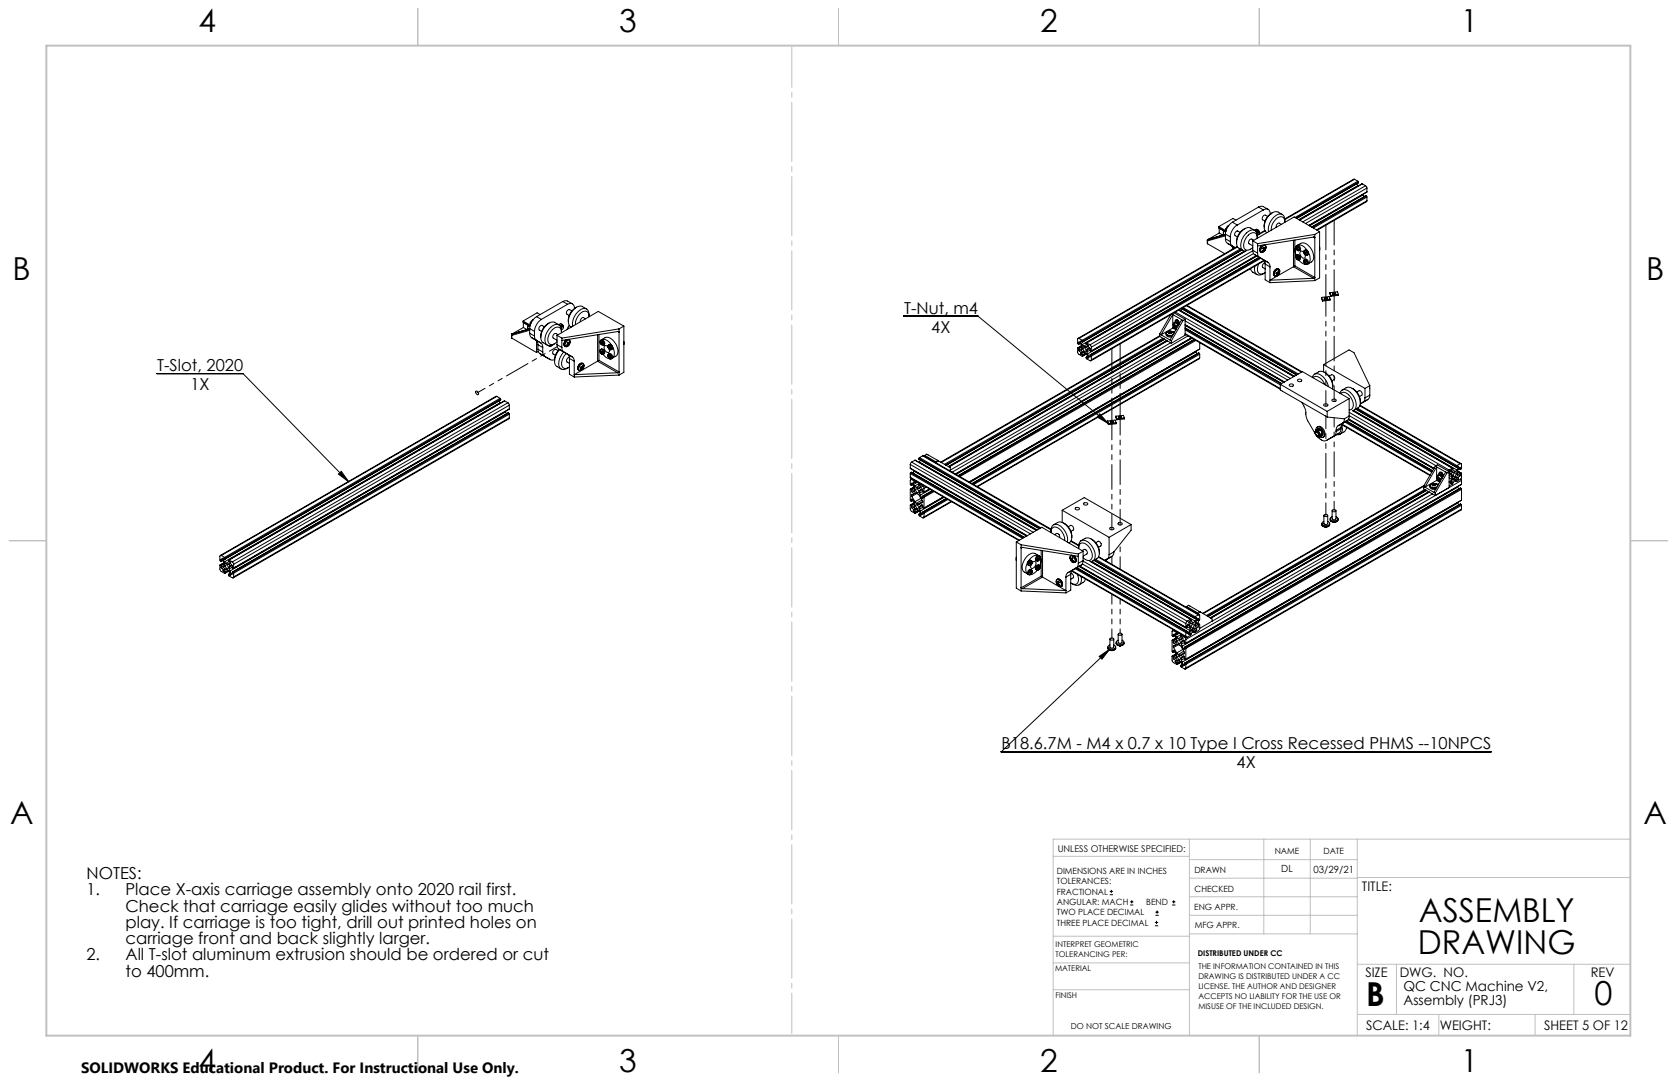
[picture p32: page 5]
T-Slot, 2020; T-Nut, m4; SCALE: 1:4; WEIGHT:

B18.6.7M - M4 x 0.7 x 10 Type I Cross Recessed PHMS --10NPCS

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

NOTES:
1. Place X-axis carriage assembly onto 2020 rail first.
Check that carriage easily glides without too much
play. If carriage is too tight, drill out printed holes on
carriage front and back slightly larger.
2. All T-slot aluminum extrusion should be ordered or cut

CHECKED | | | TITLE: ASSEMBLY DRAWING

ENG APPR.
MFG APPR.

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

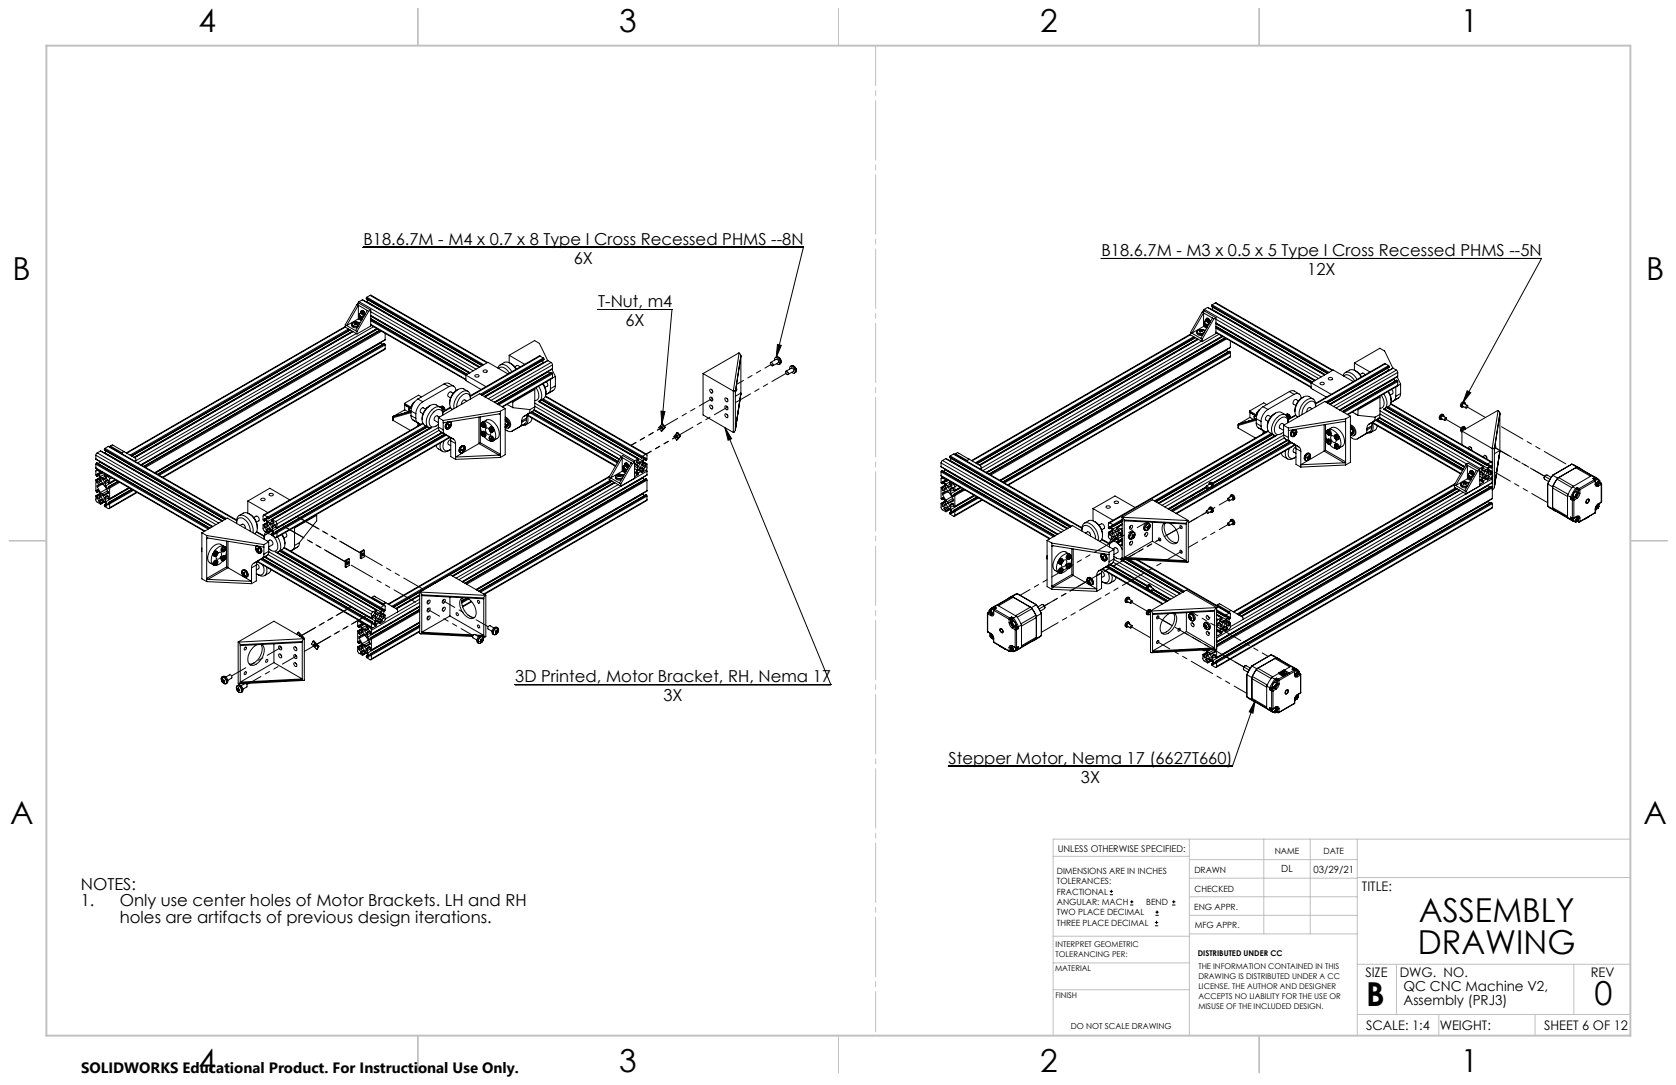
[picture p33: page 6]
T-Nut, m4; holes are artifacts of previous design iterations.; ASSEMBLY

B18.6.7M - M4 x 0.7 x 8 Type I Cross Recessed PHMS --8N

B18.6.7M - M3 x 0.5 x 5 Type I Cross Recessed PHMS --5N

3D Printed, Motor Bracket, RH, Nema 17

Stepper Motor, Nema 17 (6627T660)

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

NOTES:
1. Only use center holes of Motor Brackets. LH and RH

CHECKED | | | TITLE: DRAWING

ENG APPR.
MFG APPR.

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

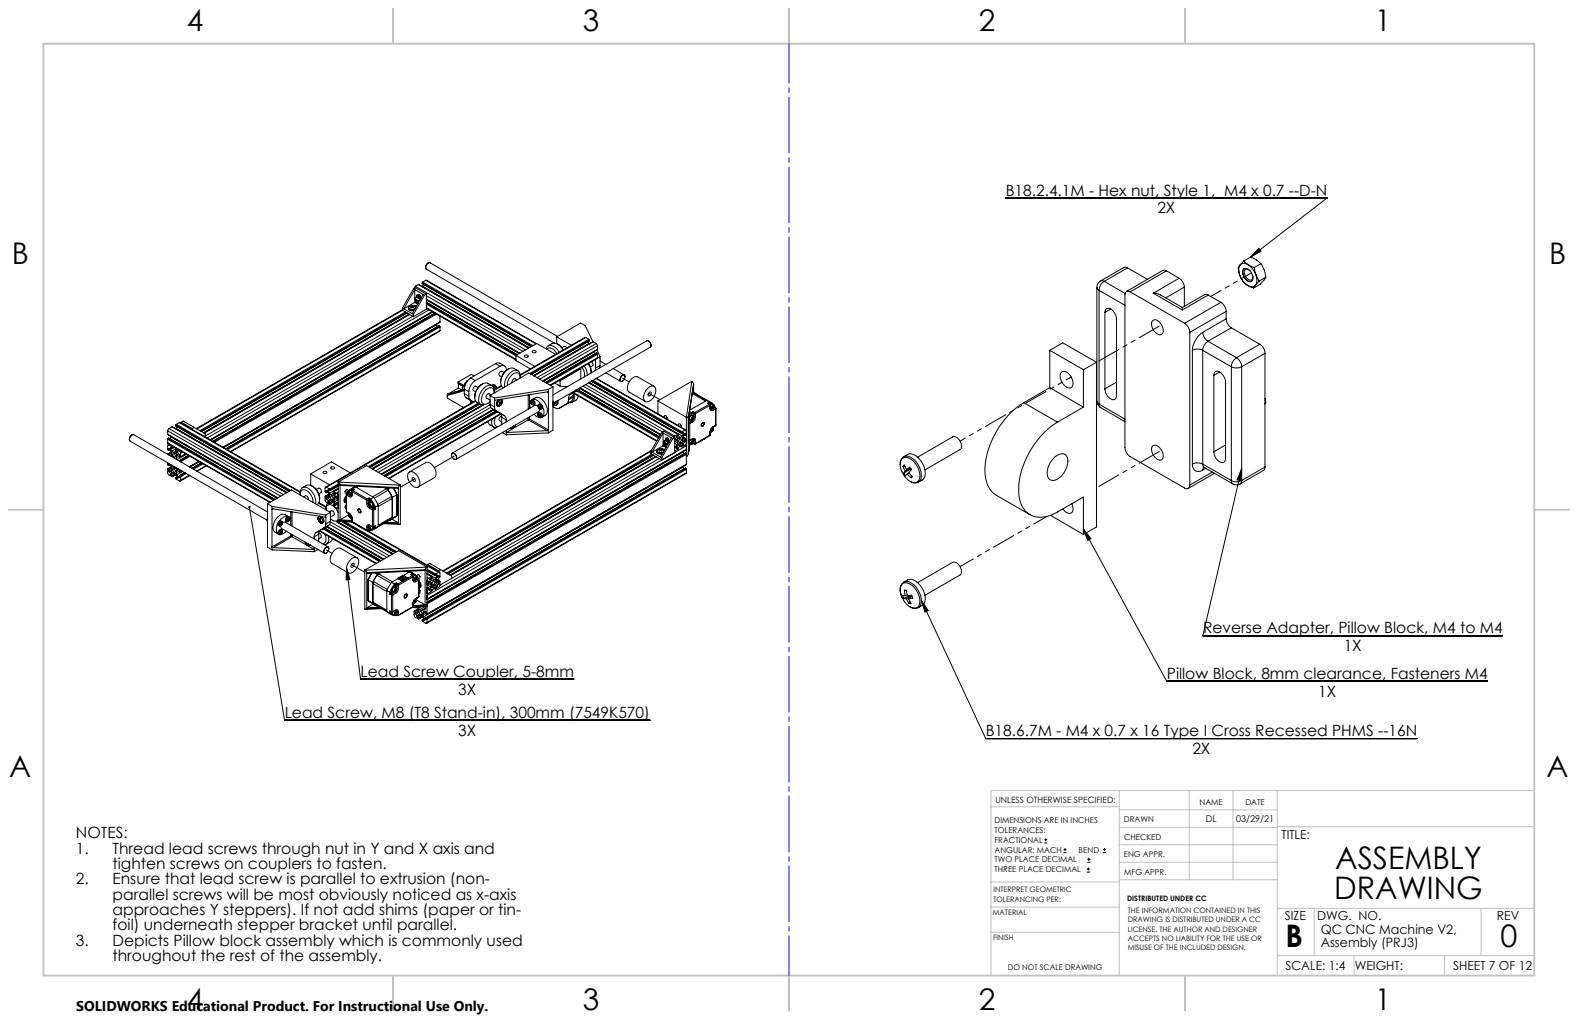
[picture p34: page 7]

B18.2.4.1M - Hex nut, Style 1, M4 x 0.7 --D-N

Reverse Adapter, Pillow Block, M4 to M4

Lead Screw Coupler, 5-8mm

Pillow Block, 8mm clearance, Fasteners M4

Lead Screw, M8 (T8 Stand-in), 300mm (7549K570)

B18.6.7M - M4 x 0.7 x 16 Type I Cross Recessed PHMS --16N

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

NOTES:
1. Thread lead screws through nut in Y and X axis and
tighten screws on couplers to fasten.
2. Ensure that lead screw is parallel to extrusion (non-
parallel screws will be most obviously noticed as x-axis
approaches Y steppers). If not add shims (paper or tin-
foil) underneath stepper bracket until parallel.
3. Depicts Pillow block assembly which is commonly used
throughout the rest of the assembly.

CHECKED | | | TITLE: ASSEMBLY DRAWING

ENG APPR.
MFG APPR.

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

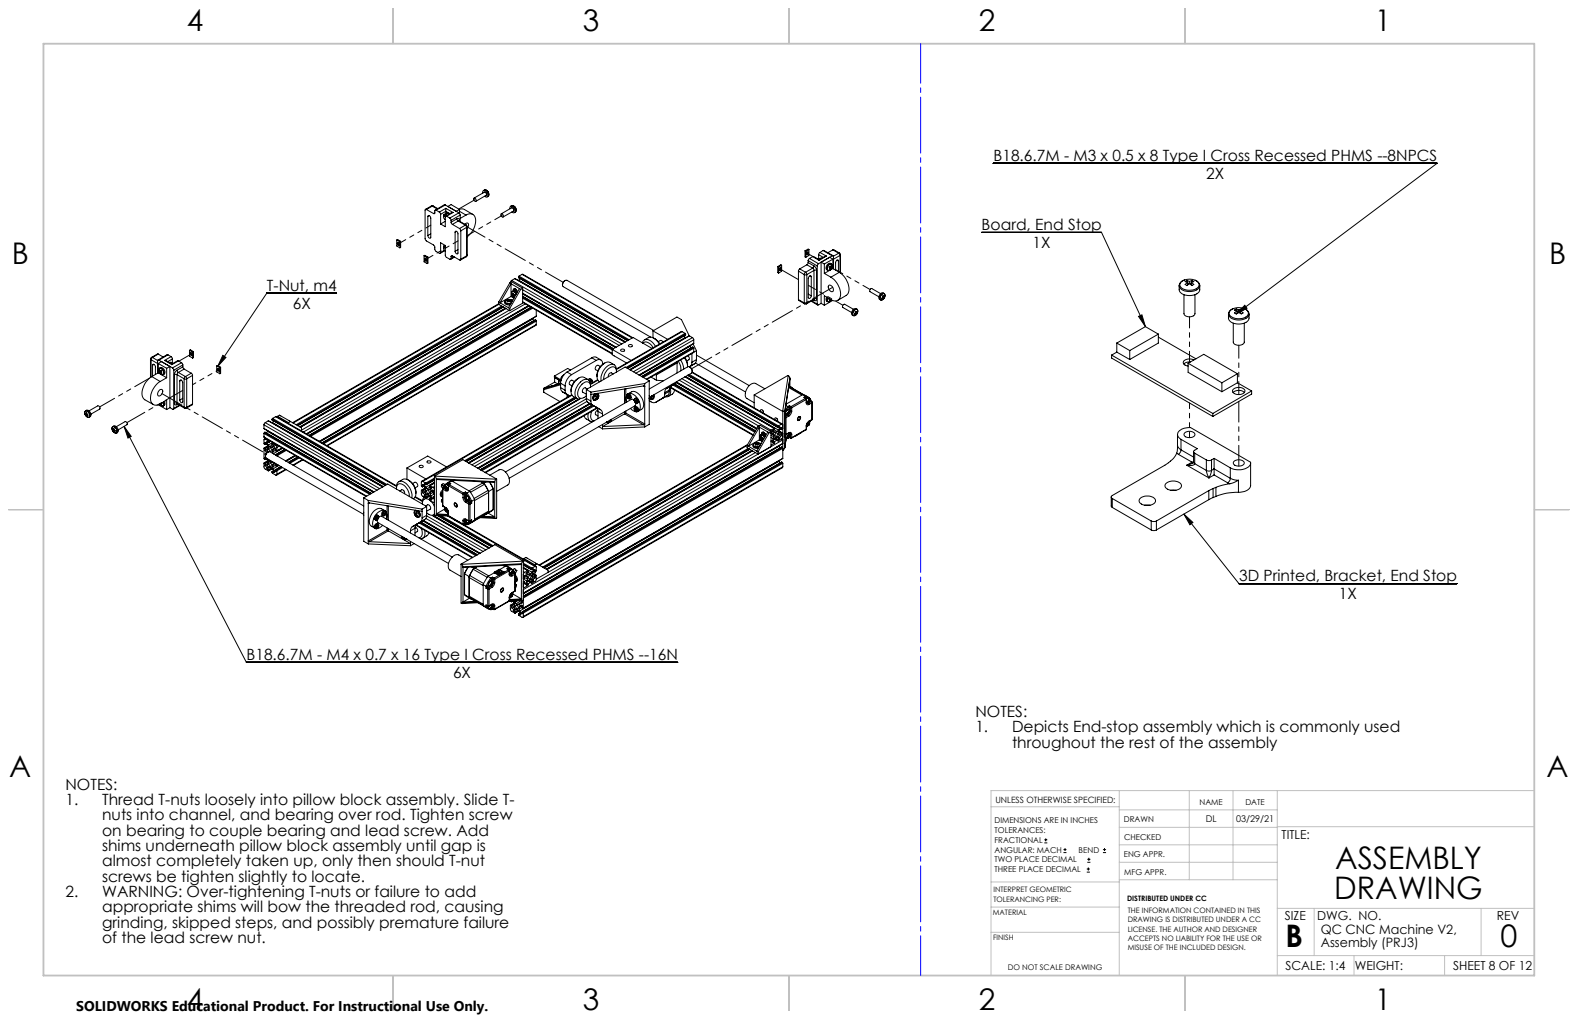
[picture p35: page 8]
T-Nut, m4

B18.6.7M - M3 x 0.5 x 8 Type I Cross Recessed PHMS --8NPCS

Board, End Stop

3D Printed, Bracket, End Stop

B18.6.7M - M4 x 0.7 x 16 Type I Cross Recessed PHMS --16N

NOTES:
1. Depicts End-stop assembly which is commonly used
throughout the rest of the assembly

1. Thread T-nuts loosely into pillow block assembly. Slide T-
nuts into channel, and bearing over rod. Tighten screw
on bearing to couple bearing and lead screw. Add
shims underneath pillow block assembly until gap is
almost completely taken up, only then should T-nut
screws be tighten slightly to locate.
2. WARNING: Over-tightening T-nuts or failure to add
appropriate shims will bow the threaded rod, causing
grinding, skipped steps, and possibly premature failure
of the lead screw nut.

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

CHECKED | | | TITLE: ASSEMBLY DRAWING

ENG APPR.
MFG APPR.

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

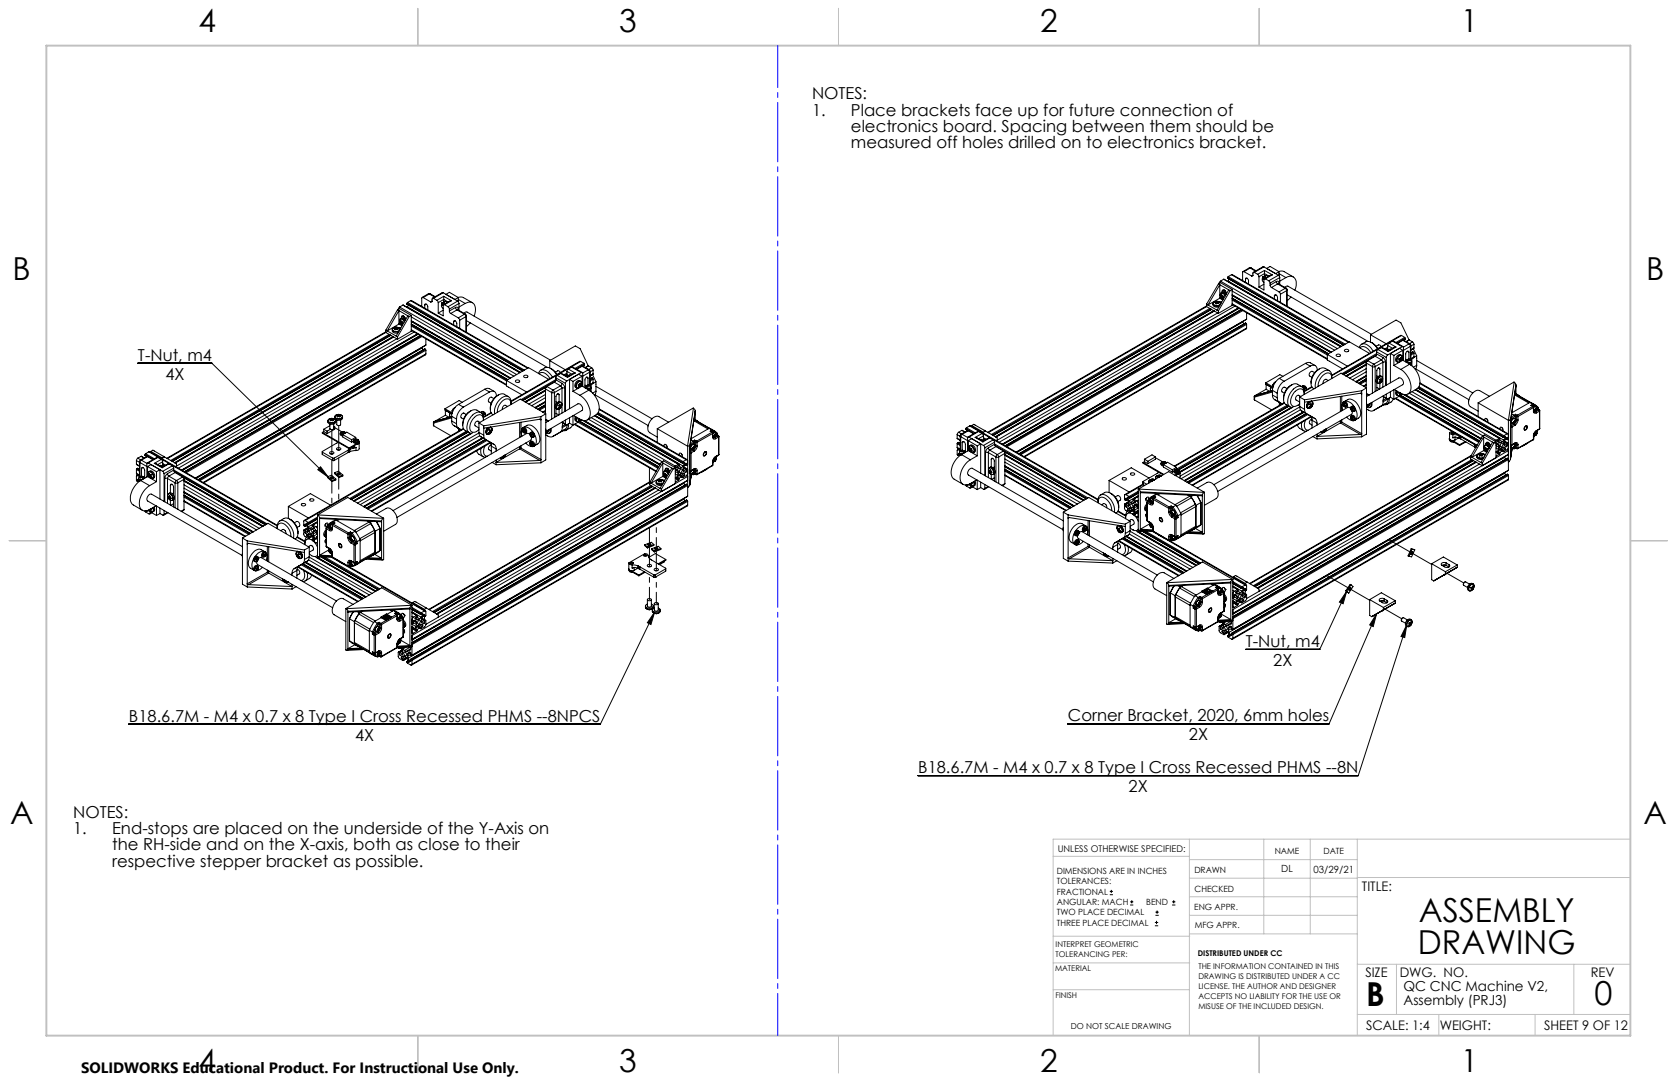
[picture p36: page 9]
T-Nut, m4

NOTES:
1. Place brackets face up for future connection of
electronics board. Spacing between them should be
measured off holes drilled on to electronics bracket.

B18.6.7M - M4 x 0.7 x 8 Type I Cross Recessed PHMS --8NPCS

Corner Bracket, 2020, 6mm holes

B18.6.7M - M4 x 0.7 x 8 Type I Cross Recessed PHMS --8N

1. End-stops are placed on the underside of the Y-Axis on
the RH-side and on the X-axis, both as close to their
respective stepper bracket as possible.

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

CHECKED | | | TITLE: ASSEMBLY DRAWING

ENG APPR.
MFG APPR.

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

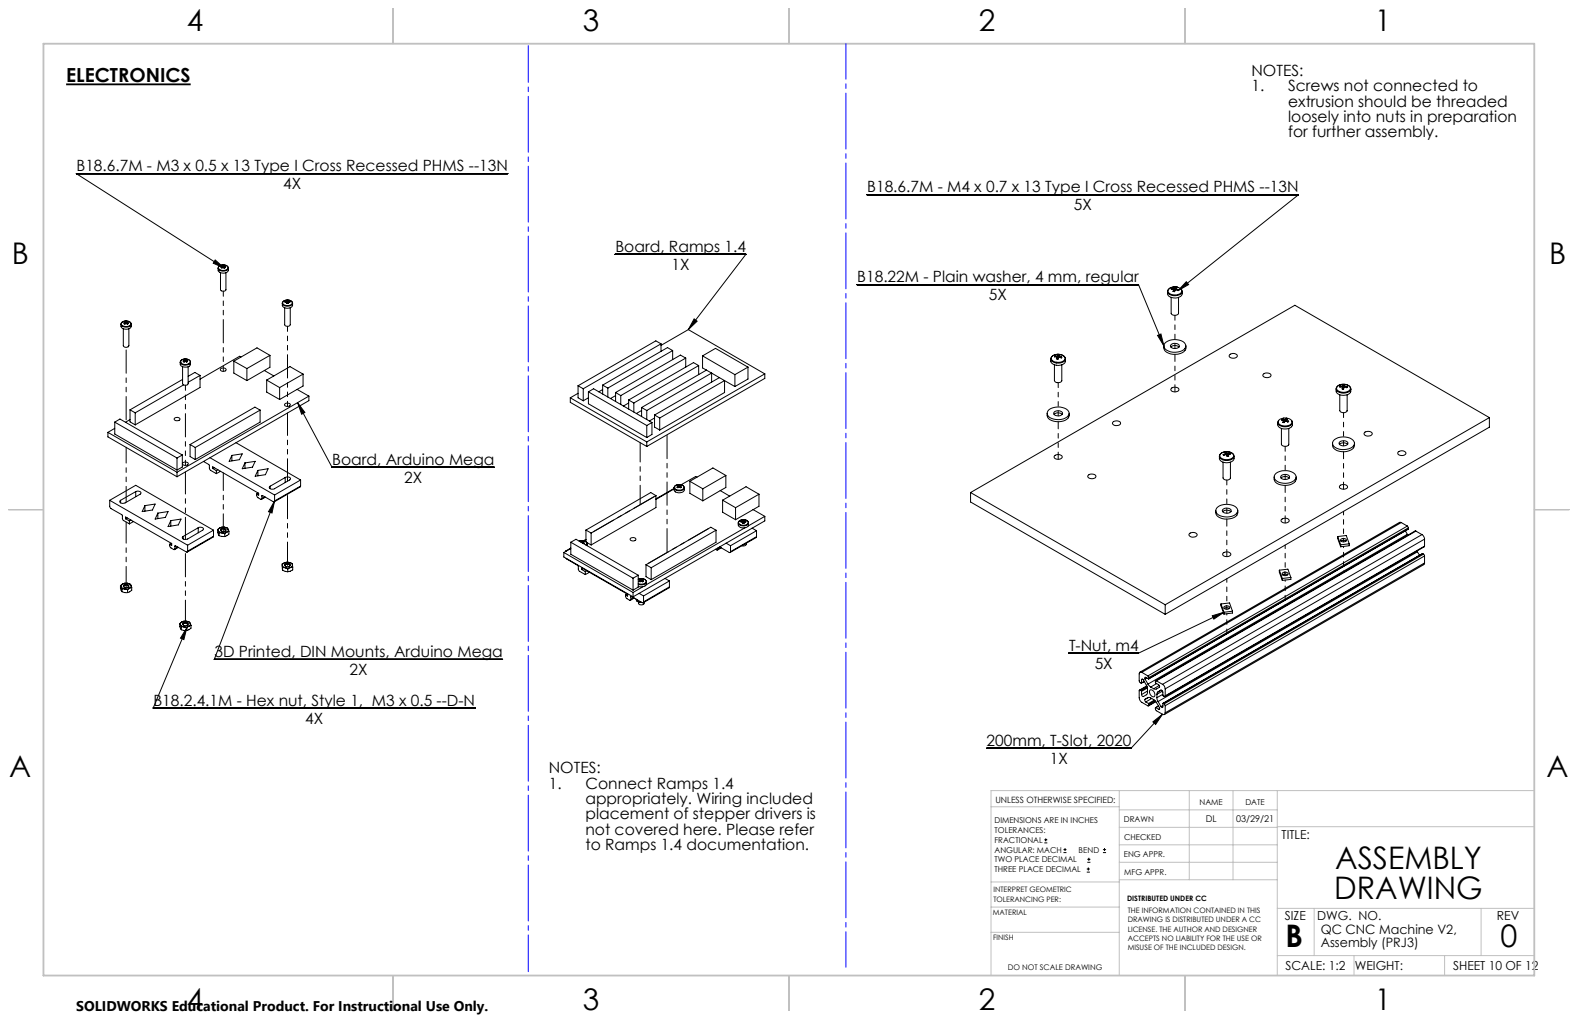
[picture p37: page 10]
Board, Ramps 1.4; T-Nut, m4; 200mm, T-Slot, 2020

1. Screws not connected to
extrusion should be threaded
loosely into nuts in preparation
for further assembly.

B18.6.7M - M3 x 0.5 x 13 Type I Cross Recessed PHMS --13N

B18.6.7M - M4 x 0.7 x 13 Type I Cross Recessed PHMS --13N

B18.22M - Plain washer, 4 mm, regular

Board, Arduino Mega

3D Printed, DIN Mounts, Arduino Mega

B18.2.4.1M - Hex nut, Style 1, M3 x 0.5 --D-N

1X NOTES:
1. Connect Ramps 1.4
appropriately. Wiring included
placement of stepper drivers is
not covered here. Please refer
to Ramps 1.4 documentation.

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

CHECKED | | | TITLE: ASSEMBLY DRAWING

ENG APPR.
MFG APPR.

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

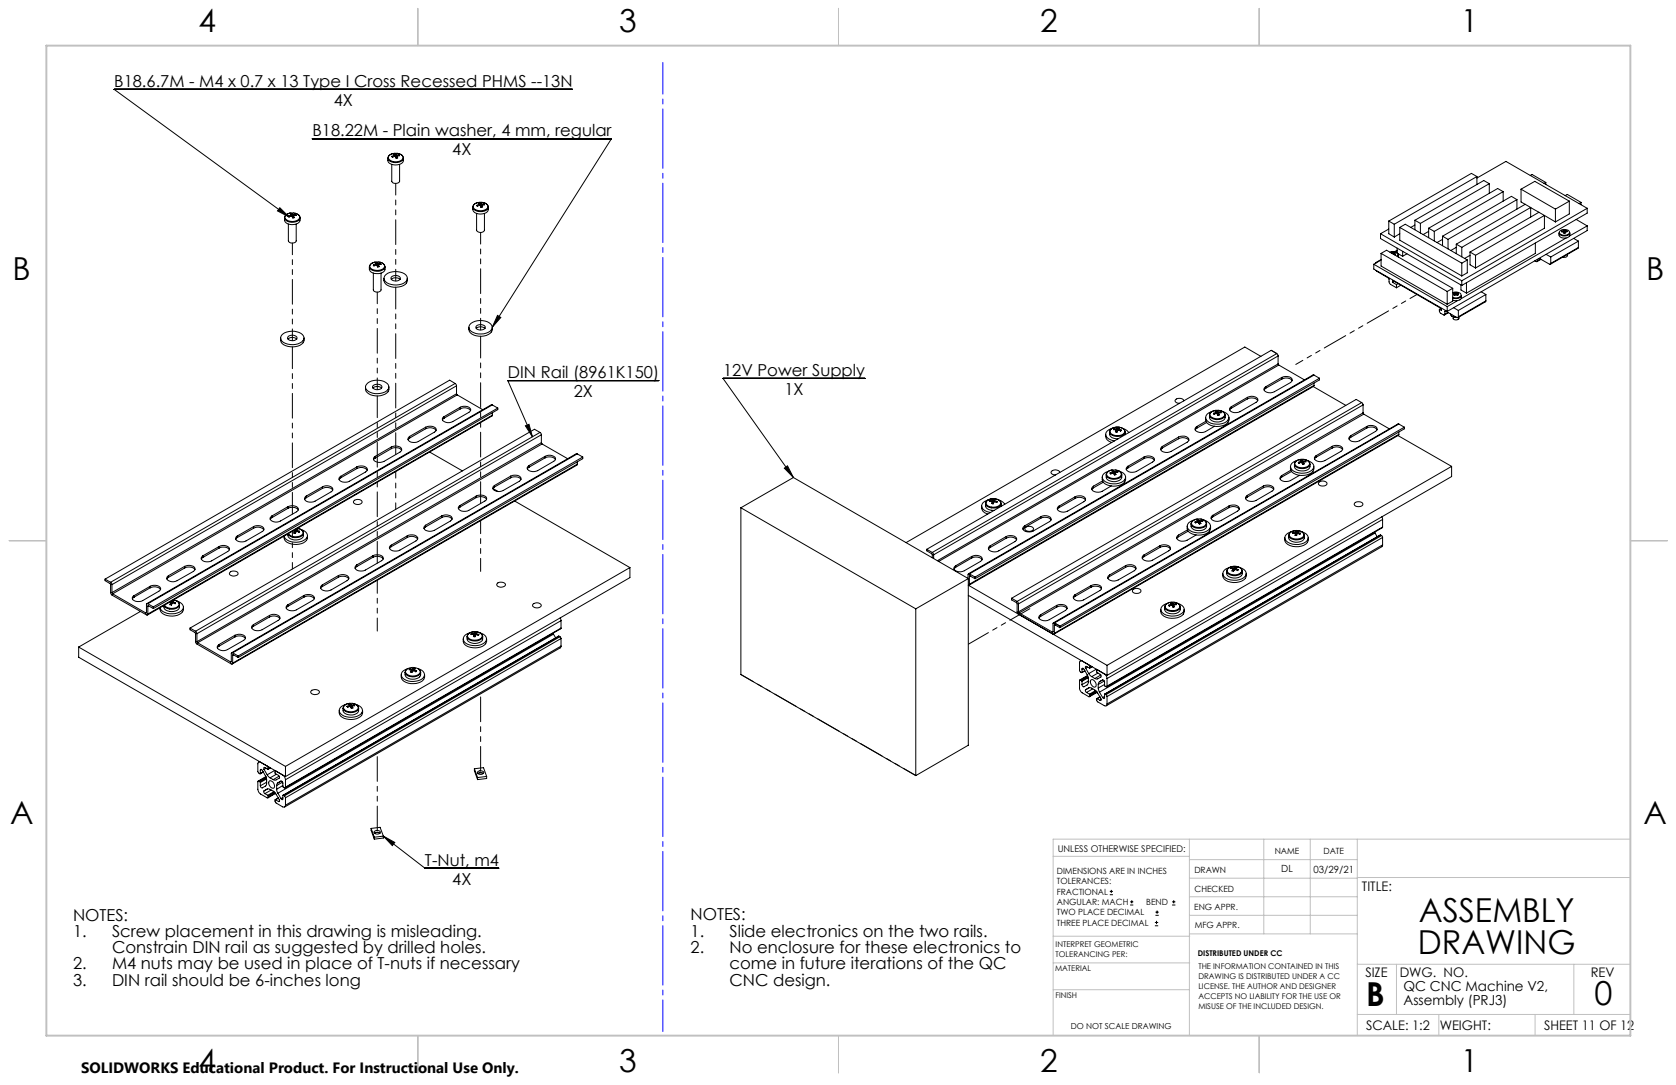
[picture p38: page 11]
T-Nut, m4; DIN Rail (8961K150); 12V Power Supply

B18.6.7M - M4 x 0.7 x 13 Type I Cross Recessed PHMS --13N

B18.22M - Plain washer, 4 mm, regular

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

CHECKED | | | TITLE: ASSEMBLY DRAWING

NOTES:
1. Screw placement in this drawing is misleading.
Constrain DIN rail as suggested by drilled holes.
2. M4 nuts may be used in place of T-nuts if necessary
3. DIN rail should be 6-inches long

1. Slide electronics on the two rails.
2. No enclosure for these electronics to
come in future iterations of the QC
CNC design.

ENG APPR.
MFG APPR.

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

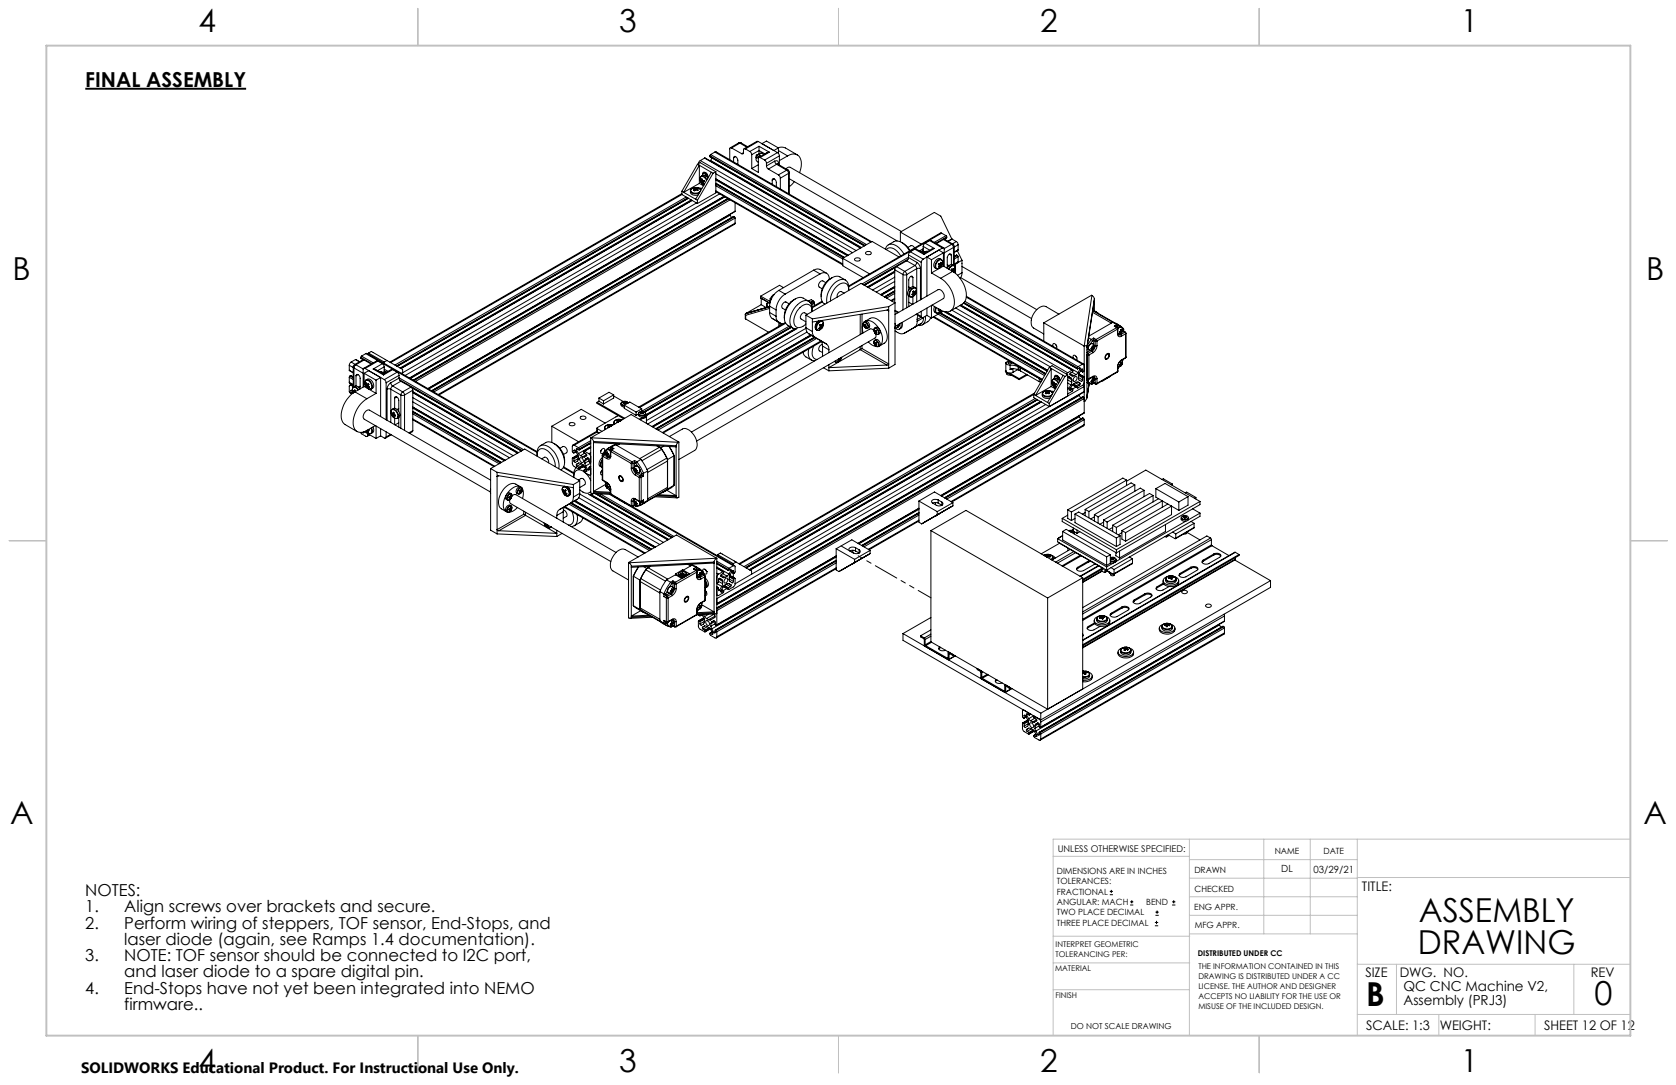
[picture p39: page 12]
FINAL ASSEMBLY; SCALE: 1:3; WEIGHT:

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

NOTES:
1. Align screws over brackets and secure.
2. Perform wiring of steppers, TOF sensor, End-Stops, and
laser diode (again, see Ramps 1.4 documentation).
3. NOTE: TOF sensor should be connected to I2C port,
and laser diode to a spare digital pin.
4. End-Stops have not yet been integrated into NEMO
firmware..

CHECKED | | | TITLE: ASSEMBLY DRAWING

ENG APPR.
MFG APPR.

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
